robotron10/project_x/README.md

# project_x
Abschlussprojekt automatisches Gewächshaus
