robotron10/project_x/doxygen/latex/pumpe__1_8cpp.tex

\hypertarget{pumpe__1_8cpp}{}\section{/home/zero/abschlussprojekt/pumpe\+\_\+1.cpp-\/\+Dateireferenz}
\label{pumpe__1_8cpp}\index{/home/zero/abschlussprojekt/pumpe\+\_\+1.\+cpp@{/home/zero/abschlussprojekt/pumpe\+\_\+1.\+cpp}}
{\ttfamily \#include $<$Arduino.\+h$>$}\newline
{\ttfamily \#include \char`\"{}makros.\+h\char`\"{}}\newline
{\ttfamily \#include \char`\"{}tuer\+\_\+zu.\+h\char`\"{}}\newline
{\ttfamily \#include \char`\"{}pumpe\+\_\+1.\+h\char`\"{}}\newline
Include-\/\+Abhängigkeitsdiagramm für pumpe\+\_\+1.\+cpp\+:
\nopagebreak
\begin{figure}[H]
\begin{center}
\leavevmode
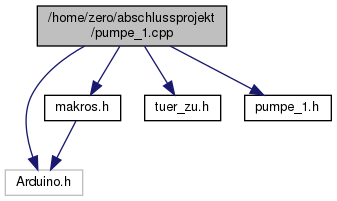
[picture p2: doxygen/html/pumpe__1_8cpp__incl.png]

\end{center}
\end{figure}
\subsection*{Funktionen}
\begin{DoxyCompactItemize}
\item 
void \hyperlink{pumpe__1_8cpp_ab395b141ee439daa2552b2aee993de59}{pumpen\+\_\+1} ()
\begin{DoxyCompactList}\small\item\em Zustandsautomat Pumpe 1 ///. \end{DoxyCompactList}\end{DoxyCompactItemize}
\subsection*{Variablen}
\begin{DoxyCompactItemize}
\item 
int \hyperlink{pumpe__1_8cpp_afa416e7460cf043207be351d750b97fe}{hum\+\_\+erde\+\_\+1\+\_\+adc}
\item 
int \hyperlink{pumpe__1_8cpp_abb1c509cfb119e70585771234accdc4c}{limit\+\_\+feuchte\+\_\+1\+\_\+adc}
\item 
unsigned long \hyperlink{pumpe__1_8cpp_abb7944bc8f9499e8ee84d361d823f122}{t0\+\_\+pumpe\+\_\+1}
\item 
unsigned long \hyperlink{pumpe__1_8cpp_ad2fcb732158343baf6f03db3f44377d0}{dt\+\_\+pumpendauer\+\_\+1\+\_\+ms} = 5000
\item 
unsigned long \hyperlink{pumpe__1_8cpp_a562f2a69077e9416bef8bcb843261334}{t0\+\_\+durchfeuchtung\+\_\+1}
\item 
unsigned long \hyperlink{pumpe__1_8cpp_a8dcdc9f5bd8d9fd59fdf7a54869ebd81}{dt\+\_\+warten\+\_\+durchfeuchtung\+\_\+1\+\_\+ms} = 10000
\item 
int \hyperlink{pumpe__1_8cpp_a312a74000d8f9d74536e66d0a5e7bfc4}{zustand\+\_\+1} = \hyperlink{makros_8h_acd99f73b20037e5fcba7a4a031e0f320}{zustand\+\_\+warten\+\_\+zu\+\_\+trocken}
\end{DoxyCompactItemize}

\subsection{Dokumentation der Funktionen}
\mbox{\Hypertarget{pumpe__1_8cpp_ab395b141ee439daa2552b2aee993de59}\label{pumpe__1_8cpp_ab395b141ee439daa2552b2aee993de59}} 
\index{pumpe\+\_\+1.\+cpp@{pumpe\+\_\+1.\+cpp}!pumpen\+\_\+1@{pumpen\+\_\+1}}
\index{pumpen\+\_\+1@{pumpen\+\_\+1}!pumpe\+\_\+1.\+cpp@{pumpe\+\_\+1.\+cpp}}
\subsubsection{\texorpdfstring{pumpen\+\_\+1()}{pumpen\_1()}}
{\footnotesize\ttfamily void pumpen\+\_\+1 (\begin{DoxyParamCaption}\item[{void}]{ }\end{DoxyParamCaption})}

Zustandsautomat Pumpe 1 ///. 

Definiert in Zeile 16 der Datei pumpe\+\_\+1.\+cpp.

\subsection{Variablen-\/\+Dokumentation}
\mbox{\Hypertarget{pumpe__1_8cpp_ad2fcb732158343baf6f03db3f44377d0}\label{pumpe__1_8cpp_ad2fcb732158343baf6f03db3f44377d0}} 
\index{pumpe\+\_\+1.\+cpp@{pumpe\+\_\+1.\+cpp}!dt\+\_\+pumpendauer\+\_\+1\+\_\+ms@{dt\+\_\+pumpendauer\+\_\+1\+\_\+ms}}
\index{dt\+\_\+pumpendauer\+\_\+1\+\_\+ms@{dt\+\_\+pumpendauer\+\_\+1\+\_\+ms}!pumpe\+\_\+1.\+cpp@{pumpe\+\_\+1.\+cpp}}
\subsubsection{\texorpdfstring{dt\+\_\+pumpendauer\+\_\+1\+\_\+ms}{dt\_pumpendauer\_1\_ms}}
{\footnotesize\ttfamily unsigned long dt\+\_\+pumpendauer\+\_\+1\+\_\+ms = 5000}

Definiert in Zeile 10 der Datei pumpe\+\_\+1.\+cpp.

\mbox{\Hypertarget{pumpe__1_8cpp_a8dcdc9f5bd8d9fd59fdf7a54869ebd81}\label{pumpe__1_8cpp_a8dcdc9f5bd8d9fd59fdf7a54869ebd81}} 
\index{pumpe\+\_\+1.\+cpp@{pumpe\+\_\+1.\+cpp}!dt\+\_\+warten\+\_\+durchfeuchtung\+\_\+1\+\_\+ms@{dt\+\_\+warten\+\_\+durchfeuchtung\+\_\+1\+\_\+ms}}
\index{dt\+\_\+warten\+\_\+durchfeuchtung\+\_\+1\+\_\+ms@{dt\+\_\+warten\+\_\+durchfeuchtung\+\_\+1\+\_\+ms}!pumpe\+\_\+1.\+cpp@{pumpe\+\_\+1.\+cpp}}
\subsubsection{\texorpdfstring{dt\+\_\+warten\+\_\+durchfeuchtung\+\_\+1\+\_\+ms}{dt\_warten\_durchfeuchtung\_1\_ms}}
{\footnotesize\ttfamily unsigned long dt\+\_\+warten\+\_\+durchfeuchtung\+\_\+1\+\_\+ms = 10000}

Definiert in Zeile 12 der Datei pumpe\+\_\+1.\+cpp.

\mbox{\Hypertarget{pumpe__1_8cpp_afa416e7460cf043207be351d750b97fe}\label{pumpe__1_8cpp_afa416e7460cf043207be351d750b97fe}} 
\index{pumpe\+\_\+1.\+cpp@{pumpe\+\_\+1.\+cpp}!hum\+\_\+erde\+\_\+1\+\_\+adc@{hum\+\_\+erde\+\_\+1\+\_\+adc}}
\index{hum\+\_\+erde\+\_\+1\+\_\+adc@{hum\+\_\+erde\+\_\+1\+\_\+adc}!pumpe\+\_\+1.\+cpp@{pumpe\+\_\+1.\+cpp}}
\subsubsection{\texorpdfstring{hum\+\_\+erde\+\_\+1\+\_\+adc}{hum\_erde\_1\_adc}}
{\footnotesize\ttfamily int hum\+\_\+erde\+\_\+1\+\_\+adc}

Definiert in Zeile 46 der Datei abschlussprojekt.\+c.

\mbox{\Hypertarget{pumpe__1_8cpp_abb1c509cfb119e70585771234accdc4c}\label{pumpe__1_8cpp_abb1c509cfb119e70585771234accdc4c}} 
\index{pumpe\+\_\+1.\+cpp@{pumpe\+\_\+1.\+cpp}!limit\+\_\+feuchte\+\_\+1\+\_\+adc@{limit\+\_\+feuchte\+\_\+1\+\_\+adc}}
\index{limit\+\_\+feuchte\+\_\+1\+\_\+adc@{limit\+\_\+feuchte\+\_\+1\+\_\+adc}!pumpe\+\_\+1.\+cpp@{pumpe\+\_\+1.\+cpp}}
\subsubsection{\texorpdfstring{limit\+\_\+feuchte\+\_\+1\+\_\+adc}{limit\_feuchte\_1\_adc}}
{\footnotesize\ttfamily int limit\+\_\+feuchte\+\_\+1\+\_\+adc}

Definiert in Zeile 52 der Datei abschlussprojekt.\+c.

\mbox{\Hypertarget{pumpe__1_8cpp_a562f2a69077e9416bef8bcb843261334}\label{pumpe__1_8cpp_a562f2a69077e9416bef8bcb843261334}} 
\index{pumpe\+\_\+1.\+cpp@{pumpe\+\_\+1.\+cpp}!t0\+\_\+durchfeuchtung\+\_\+1@{t0\+\_\+durchfeuchtung\+\_\+1}}
\index{t0\+\_\+durchfeuchtung\+\_\+1@{t0\+\_\+durchfeuchtung\+\_\+1}!pumpe\+\_\+1.\+cpp@{pumpe\+\_\+1.\+cpp}}
\subsubsection{\texorpdfstring{t0\+\_\+durchfeuchtung\+\_\+1}{t0\_durchfeuchtung\_1}}
{\footnotesize\ttfamily unsigned long t0\+\_\+durchfeuchtung\+\_\+1}

Definiert in Zeile 11 der Datei pumpe\+\_\+1.\+cpp.

\mbox{\Hypertarget{pumpe__1_8cpp_abb7944bc8f9499e8ee84d361d823f122}\label{pumpe__1_8cpp_abb7944bc8f9499e8ee84d361d823f122}} 
\index{pumpe\+\_\+1.\+cpp@{pumpe\+\_\+1.\+cpp}!t0\+\_\+pumpe\+\_\+1@{t0\+\_\+pumpe\+\_\+1}}
\index{t0\+\_\+pumpe\+\_\+1@{t0\+\_\+pumpe\+\_\+1}!pumpe\+\_\+1.\+cpp@{pumpe\+\_\+1.\+cpp}}
\subsubsection{\texorpdfstring{t0\+\_\+pumpe\+\_\+1}{t0\_pumpe\_1}}
{\footnotesize\ttfamily unsigned long t0\+\_\+pumpe\+\_\+1}

Definiert in Zeile 9 der Datei pumpe\+\_\+1.\+cpp.

\mbox{\Hypertarget{pumpe__1_8cpp_a312a74000d8f9d74536e66d0a5e7bfc4}\label{pumpe__1_8cpp_a312a74000d8f9d74536e66d0a5e7bfc4}} 
\index{pumpe\+\_\+1.\+cpp@{pumpe\+\_\+1.\+cpp}!zustand\+\_\+1@{zustand\+\_\+1}}
\index{zustand\+\_\+1@{zustand\+\_\+1}!pumpe\+\_\+1.\+cpp@{pumpe\+\_\+1.\+cpp}}
\subsubsection{\texorpdfstring{zustand\+\_\+1}{zustand\_1}}
{\footnotesize\ttfamily int zustand\+\_\+1 = \hyperlink{makros_8h_acd99f73b20037e5fcba7a4a031e0f320}{zustand\+\_\+warten\+\_\+zu\+\_\+trocken}}

Definiert in Zeile 14 der Datei pumpe\+\_\+1.\+cpp.
