robotron10/project_x/doxygen/latex/pumpe__1_8h.tex

\hypertarget{pumpe__1_8h}{}\section{/home/zero/abschlussprojekt/pumpe\+\_\+1.h-\/\+Dateireferenz}
\label{pumpe__1_8h}\index{/home/zero/abschlussprojekt/pumpe\+\_\+1.\+h@{/home/zero/abschlussprojekt/pumpe\+\_\+1.\+h}}
Dieser Graph zeigt, welche Datei direkt oder indirekt diese Datei enthält\+:
\nopagebreak
\begin{figure}[H]
\begin{center}
\leavevmode
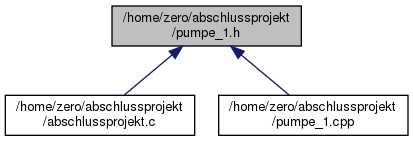
[picture p3: doxygen/html/pumpe__1_8h__dep__incl.png]

\end{center}
\end{figure}
\subsection*{Funktionen}
\begin{DoxyCompactItemize}
\item 
void \hyperlink{pumpe__1_8h_ad672a4455a5f5c803b5fd5ad87a41aa0}{pumpen\+\_\+1} (void)
\begin{DoxyCompactList}\small\item\em Zustandsautomat Pumpe 1 ///. \end{DoxyCompactList}\end{DoxyCompactItemize}

\subsection{Dokumentation der Funktionen}
\mbox{\Hypertarget{pumpe__1_8h_ad672a4455a5f5c803b5fd5ad87a41aa0}\label{pumpe__1_8h_ad672a4455a5f5c803b5fd5ad87a41aa0}} 
\index{pumpe\+\_\+1.\+h@{pumpe\+\_\+1.\+h}!pumpen\+\_\+1@{pumpen\+\_\+1}}
\index{pumpen\+\_\+1@{pumpen\+\_\+1}!pumpe\+\_\+1.\+h@{pumpe\+\_\+1.\+h}}
\subsubsection{\texorpdfstring{pumpen\+\_\+1()}{pumpen\_1()}}
{\footnotesize\ttfamily void pumpen\+\_\+1 (\begin{DoxyParamCaption}\item[{void}]{ }\end{DoxyParamCaption})}

Zustandsautomat Pumpe 1 ///. 

Definiert in Zeile 16 der Datei pumpe\+\_\+1.\+cpp.
