robotron10/project_x/doxygen/latex/pumpe__2_8cpp.tex

\hypertarget{pumpe__2_8cpp}{}\section{/home/zero/abschlussprojekt/pumpe\+\_\+2.cpp-\/\+Dateireferenz}
\label{pumpe__2_8cpp}\index{/home/zero/abschlussprojekt/pumpe\+\_\+2.\+cpp@{/home/zero/abschlussprojekt/pumpe\+\_\+2.\+cpp}}
{\ttfamily \#include $<$Arduino.\+h$>$}\newline
{\ttfamily \#include \char`\"{}makros.\+h\char`\"{}}\newline
{\ttfamily \#include \char`\"{}tuer\+\_\+zu.\+h\char`\"{}}\newline
{\ttfamily \#include \char`\"{}pumpe\+\_\+2.\+h\char`\"{}}\newline
Include-\/\+Abhängigkeitsdiagramm für pumpe\+\_\+2.\+cpp\+:
\nopagebreak
\begin{figure}[H]
\begin{center}
\leavevmode
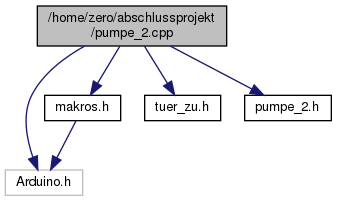
[picture p4: doxygen/html/pumpe__2_8cpp__incl.png]

\end{center}
\end{figure}
\subsection*{Funktionen}
\begin{DoxyCompactItemize}
\item 
void \hyperlink{pumpe__2_8cpp_ab5052e43d029ec1d5b2899be0135e45c}{pumpen\+\_\+2} ()
\begin{DoxyCompactList}\small\item\em Zustandsautomat Pumpe 2 ///. \end{DoxyCompactList}\end{DoxyCompactItemize}
\subsection*{Variablen}
\begin{DoxyCompactItemize}
\item 
int \hyperlink{pumpe__2_8cpp_aacdbec939adcfa404b8c42b2e064b110}{hum\+\_\+erde\+\_\+2\+\_\+adc}
\item 
int \hyperlink{pumpe__2_8cpp_a11941af86181c1d0476b4bad92345dee}{limit\+\_\+feuchte\+\_\+2\+\_\+adc}
\item 
unsigned long \hyperlink{pumpe__2_8cpp_a6ba123b4db543f23167f7579070cb078}{t0\+\_\+pumpe\+\_\+2}
\item 
unsigned long \hyperlink{pumpe__2_8cpp_aa162b2945b33207aaa0e405a04e21049}{dt\+\_\+pumpendauer\+\_\+2\+\_\+ms} = 5000
\item 
unsigned long \hyperlink{pumpe__2_8cpp_ae43a32686ec363ab79244493e815eb1a}{t0\+\_\+durchfeuchtung\+\_\+2}
\item 
unsigned long \hyperlink{pumpe__2_8cpp_ad4082581e55599e78402c968aa6fd220}{dt\+\_\+warten\+\_\+durchfeuchtung\+\_\+2\+\_\+ms} = 10000
\item 
int \hyperlink{pumpe__2_8cpp_ae5d230a4da9cb370063e945d94d7043a}{zustand\+\_\+2} = \hyperlink{makros_8h_acd99f73b20037e5fcba7a4a031e0f320}{zustand\+\_\+warten\+\_\+zu\+\_\+trocken}
\end{DoxyCompactItemize}

\subsection{Dokumentation der Funktionen}
\mbox{\Hypertarget{pumpe__2_8cpp_ab5052e43d029ec1d5b2899be0135e45c}\label{pumpe__2_8cpp_ab5052e43d029ec1d5b2899be0135e45c}} 
\index{pumpe\+\_\+2.\+cpp@{pumpe\+\_\+2.\+cpp}!pumpen\+\_\+2@{pumpen\+\_\+2}}
\index{pumpen\+\_\+2@{pumpen\+\_\+2}!pumpe\+\_\+2.\+cpp@{pumpe\+\_\+2.\+cpp}}
\subsubsection{\texorpdfstring{pumpen\+\_\+2()}{pumpen\_2()}}
{\footnotesize\ttfamily void pumpen\+\_\+2 (\begin{DoxyParamCaption}\item[{void}]{ }\end{DoxyParamCaption})}

Zustandsautomat Pumpe 2 ///. 

Definiert in Zeile 16 der Datei pumpe\+\_\+2.\+cpp.

\subsection{Variablen-\/\+Dokumentation}
\mbox{\Hypertarget{pumpe__2_8cpp_aa162b2945b33207aaa0e405a04e21049}\label{pumpe__2_8cpp_aa162b2945b33207aaa0e405a04e21049}} 
\index{pumpe\+\_\+2.\+cpp@{pumpe\+\_\+2.\+cpp}!dt\+\_\+pumpendauer\+\_\+2\+\_\+ms@{dt\+\_\+pumpendauer\+\_\+2\+\_\+ms}}
\index{dt\+\_\+pumpendauer\+\_\+2\+\_\+ms@{dt\+\_\+pumpendauer\+\_\+2\+\_\+ms}!pumpe\+\_\+2.\+cpp@{pumpe\+\_\+2.\+cpp}}
\subsubsection{\texorpdfstring{dt\+\_\+pumpendauer\+\_\+2\+\_\+ms}{dt\_pumpendauer\_2\_ms}}
{\footnotesize\ttfamily unsigned long dt\+\_\+pumpendauer\+\_\+2\+\_\+ms = 5000}

Definiert in Zeile 10 der Datei pumpe\+\_\+2.\+cpp.

\mbox{\Hypertarget{pumpe__2_8cpp_ad4082581e55599e78402c968aa6fd220}\label{pumpe__2_8cpp_ad4082581e55599e78402c968aa6fd220}} 
\index{pumpe\+\_\+2.\+cpp@{pumpe\+\_\+2.\+cpp}!dt\+\_\+warten\+\_\+durchfeuchtung\+\_\+2\+\_\+ms@{dt\+\_\+warten\+\_\+durchfeuchtung\+\_\+2\+\_\+ms}}
\index{dt\+\_\+warten\+\_\+durchfeuchtung\+\_\+2\+\_\+ms@{dt\+\_\+warten\+\_\+durchfeuchtung\+\_\+2\+\_\+ms}!pumpe\+\_\+2.\+cpp@{pumpe\+\_\+2.\+cpp}}
\subsubsection{\texorpdfstring{dt\+\_\+warten\+\_\+durchfeuchtung\+\_\+2\+\_\+ms}{dt\_warten\_durchfeuchtung\_2\_ms}}
{\footnotesize\ttfamily unsigned long dt\+\_\+warten\+\_\+durchfeuchtung\+\_\+2\+\_\+ms = 10000}

Definiert in Zeile 12 der Datei pumpe\+\_\+2.\+cpp.

\mbox{\Hypertarget{pumpe__2_8cpp_aacdbec939adcfa404b8c42b2e064b110}\label{pumpe__2_8cpp_aacdbec939adcfa404b8c42b2e064b110}} 
\index{pumpe\+\_\+2.\+cpp@{pumpe\+\_\+2.\+cpp}!hum\+\_\+erde\+\_\+2\+\_\+adc@{hum\+\_\+erde\+\_\+2\+\_\+adc}}
\index{hum\+\_\+erde\+\_\+2\+\_\+adc@{hum\+\_\+erde\+\_\+2\+\_\+adc}!pumpe\+\_\+2.\+cpp@{pumpe\+\_\+2.\+cpp}}
\subsubsection{\texorpdfstring{hum\+\_\+erde\+\_\+2\+\_\+adc}{hum\_erde\_2\_adc}}
{\footnotesize\ttfamily int hum\+\_\+erde\+\_\+2\+\_\+adc}

Definiert in Zeile 47 der Datei abschlussprojekt.\+c.

\mbox{\Hypertarget{pumpe__2_8cpp_a11941af86181c1d0476b4bad92345dee}\label{pumpe__2_8cpp_a11941af86181c1d0476b4bad92345dee}} 
\index{pumpe\+\_\+2.\+cpp@{pumpe\+\_\+2.\+cpp}!limit\+\_\+feuchte\+\_\+2\+\_\+adc@{limit\+\_\+feuchte\+\_\+2\+\_\+adc}}
\index{limit\+\_\+feuchte\+\_\+2\+\_\+adc@{limit\+\_\+feuchte\+\_\+2\+\_\+adc}!pumpe\+\_\+2.\+cpp@{pumpe\+\_\+2.\+cpp}}
\subsubsection{\texorpdfstring{limit\+\_\+feuchte\+\_\+2\+\_\+adc}{limit\_feuchte\_2\_adc}}
{\footnotesize\ttfamily int limit\+\_\+feuchte\+\_\+2\+\_\+adc}

Definiert in Zeile 53 der Datei abschlussprojekt.\+c.

\mbox{\Hypertarget{pumpe__2_8cpp_ae43a32686ec363ab79244493e815eb1a}\label{pumpe__2_8cpp_ae43a32686ec363ab79244493e815eb1a}} 
\index{pumpe\+\_\+2.\+cpp@{pumpe\+\_\+2.\+cpp}!t0\+\_\+durchfeuchtung\+\_\+2@{t0\+\_\+durchfeuchtung\+\_\+2}}
\index{t0\+\_\+durchfeuchtung\+\_\+2@{t0\+\_\+durchfeuchtung\+\_\+2}!pumpe\+\_\+2.\+cpp@{pumpe\+\_\+2.\+cpp}}
\subsubsection{\texorpdfstring{t0\+\_\+durchfeuchtung\+\_\+2}{t0\_durchfeuchtung\_2}}
{\footnotesize\ttfamily unsigned long t0\+\_\+durchfeuchtung\+\_\+2}

Definiert in Zeile 11 der Datei pumpe\+\_\+2.\+cpp.

\mbox{\Hypertarget{pumpe__2_8cpp_a6ba123b4db543f23167f7579070cb078}\label{pumpe__2_8cpp_a6ba123b4db543f23167f7579070cb078}} 
\index{pumpe\+\_\+2.\+cpp@{pumpe\+\_\+2.\+cpp}!t0\+\_\+pumpe\+\_\+2@{t0\+\_\+pumpe\+\_\+2}}
\index{t0\+\_\+pumpe\+\_\+2@{t0\+\_\+pumpe\+\_\+2}!pumpe\+\_\+2.\+cpp@{pumpe\+\_\+2.\+cpp}}
\subsubsection{\texorpdfstring{t0\+\_\+pumpe\+\_\+2}{t0\_pumpe\_2}}
{\footnotesize\ttfamily unsigned long t0\+\_\+pumpe\+\_\+2}

Definiert in Zeile 9 der Datei pumpe\+\_\+2.\+cpp.

\mbox{\Hypertarget{pumpe__2_8cpp_ae5d230a4da9cb370063e945d94d7043a}\label{pumpe__2_8cpp_ae5d230a4da9cb370063e945d94d7043a}} 
\index{pumpe\+\_\+2.\+cpp@{pumpe\+\_\+2.\+cpp}!zustand\+\_\+2@{zustand\+\_\+2}}
\index{zustand\+\_\+2@{zustand\+\_\+2}!pumpe\+\_\+2.\+cpp@{pumpe\+\_\+2.\+cpp}}
\subsubsection{\texorpdfstring{zustand\+\_\+2}{zustand\_2}}
{\footnotesize\ttfamily int zustand\+\_\+2 = \hyperlink{makros_8h_acd99f73b20037e5fcba7a4a031e0f320}{zustand\+\_\+warten\+\_\+zu\+\_\+trocken}}

Definiert in Zeile 14 der Datei pumpe\+\_\+2.\+cpp.
