robotron10/project_x/doxygen/latex/pumpe__2_8h.tex

\hypertarget{pumpe__2_8h}{}\section{/home/zero/abschlussprojekt/pumpe\+\_\+2.h-\/\+Dateireferenz}
\label{pumpe__2_8h}\index{/home/zero/abschlussprojekt/pumpe\+\_\+2.\+h@{/home/zero/abschlussprojekt/pumpe\+\_\+2.\+h}}
Dieser Graph zeigt, welche Datei direkt oder indirekt diese Datei enthält\+:
\nopagebreak
\begin{figure}[H]
\begin{center}
\leavevmode
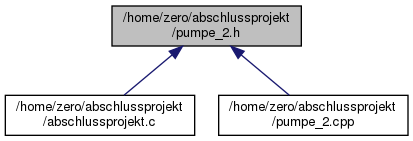
[picture p5: doxygen/html/pumpe__2_8h__dep__incl.png]

\end{center}
\end{figure}
\subsection*{Funktionen}
\begin{DoxyCompactItemize}
\item 
void \hyperlink{pumpe__2_8h_a754bd6f3d38e83cc0365704a45bf8f37}{pumpen\+\_\+2} (void)
\begin{DoxyCompactList}\small\item\em Zustandsautomat Pumpe 2 ///. \end{DoxyCompactList}\end{DoxyCompactItemize}

\subsection{Dokumentation der Funktionen}
\mbox{\Hypertarget{pumpe__2_8h_a754bd6f3d38e83cc0365704a45bf8f37}\label{pumpe__2_8h_a754bd6f3d38e83cc0365704a45bf8f37}} 
\index{pumpe\+\_\+2.\+h@{pumpe\+\_\+2.\+h}!pumpen\+\_\+2@{pumpen\+\_\+2}}
\index{pumpen\+\_\+2@{pumpen\+\_\+2}!pumpe\+\_\+2.\+h@{pumpe\+\_\+2.\+h}}
\subsubsection{\texorpdfstring{pumpen\+\_\+2()}{pumpen\_2()}}
{\footnotesize\ttfamily void pumpen\+\_\+2 (\begin{DoxyParamCaption}\item[{void}]{ }\end{DoxyParamCaption})}

Zustandsautomat Pumpe 2 ///. 

Definiert in Zeile 16 der Datei pumpe\+\_\+2.\+cpp.
