robotron10/project_x/doxygen/latex/update__lcd_8h.tex

\hypertarget{update__lcd_8h}{}\section{/home/zero/abschlussprojekt/update\+\_\+lcd.h-\/\+Dateireferenz}
\label{update__lcd_8h}\index{/home/zero/abschlussprojekt/update\+\_\+lcd.\+h@{/home/zero/abschlussprojekt/update\+\_\+lcd.\+h}}
{\ttfamily \#include $<$Arduino.\+h$>$}\newline
{\ttfamily \#include $<$Liquid\+Crystal\+\_\+\+I2\+C.\+h$>$}\newline
{\ttfamily \#include \char`\"{}make\+\_\+string.\+h\char`\"{}}\newline
Include-\/\+Abhängigkeitsdiagramm für update\+\_\+lcd.\+h\+:
\nopagebreak
\begin{figure}[H]
\begin{center}
\leavevmode
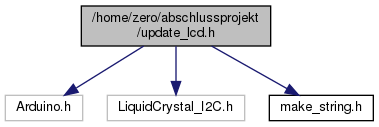
[picture p6: doxygen/html/update__lcd_8h__incl.png]

\end{center}
\end{figure}
Dieser Graph zeigt, welche Datei direkt oder indirekt diese Datei enthält\+:
\nopagebreak
\begin{figure}[H]
\begin{center}
\leavevmode
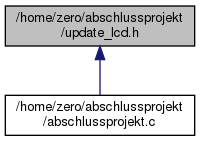
[picture p7: doxygen/html/update__lcd_8h__dep__incl.png]

\end{center}
\end{figure}
\subsection*{Funktionen}
\begin{DoxyCompactItemize}
\item 
Liquid\+Crystal\+\_\+\+I2C \hyperlink{update__lcd_8h_a7392e8043ba37d68cf0d13e0264acd85}{lcd} (0x3\+F, 20, 4)
\item 
void \hyperlink{update__lcd_8h_a23904742a80994988f92b99487c299ca}{update\+\_\+lcd} (int nr\+\_\+display, int \hyperlink{update__messwerte_8h_a0e6f058da75dead800f4a33e63586703}{temp\+\_\+luft\+\_\+C}, int \hyperlink{update__messwerte_8h_ac9fcb87eca48e4002731015e004966ef}{hum\+\_\+luft}, int \hyperlink{update__messwerte_8h_afa416e7460cf043207be351d750b97fe}{hum\+\_\+erde\+\_\+1\+\_\+adc}, int \hyperlink{update__messwerte_8h_aacdbec939adcfa404b8c42b2e064b110}{hum\+\_\+erde\+\_\+2\+\_\+adc}, int \hyperlink{update__limits_8cpp_abb1c509cfb119e70585771234accdc4c}{limit\+\_\+feuchte\+\_\+1\+\_\+adc}, int \hyperlink{update__limits_8cpp_a11941af86181c1d0476b4bad92345dee}{limit\+\_\+feuchte\+\_\+2\+\_\+adc}, int \hyperlink{update__limits_8cpp_a8f0ffb4ec25253a324ab4dac6d3cf1c4}{limit\+\_\+temp\+\_\+adc}, int \hyperlink{update__limits_8cpp_a3f6dd9ed3b997c063d7c90a38a69ab3a}{limit\+\_\+luefter\+\_\+adc})
\end{DoxyCompactItemize}

\subsection{Dokumentation der Funktionen}
\mbox{\Hypertarget{update__lcd_8h_a7392e8043ba37d68cf0d13e0264acd85}\label{update__lcd_8h_a7392e8043ba37d68cf0d13e0264acd85}} 
\index{update\+\_\+lcd.\+h@{update\+\_\+lcd.\+h}!lcd@{lcd}}
\index{lcd@{lcd}!update\+\_\+lcd.\+h@{update\+\_\+lcd.\+h}}
\subsubsection{\texorpdfstring{lcd()}{lcd()}}
{\footnotesize\ttfamily Liquid\+Crystal\+\_\+\+I2C lcd (\begin{DoxyParamCaption}\item[{0x3F}]{,  }\item[{20}]{,  }\item[{4}]{ }\end{DoxyParamCaption})}

\mbox{\Hypertarget{update__lcd_8h_a23904742a80994988f92b99487c299ca}\label{update__lcd_8h_a23904742a80994988f92b99487c299ca}} 
\index{update\+\_\+lcd.\+h@{update\+\_\+lcd.\+h}!update\+\_\+lcd@{update\+\_\+lcd}}
\index{update\+\_\+lcd@{update\+\_\+lcd}!update\+\_\+lcd.\+h@{update\+\_\+lcd.\+h}}
\subsubsection{\texorpdfstring{update\+\_\+lcd()}{update\_lcd()}}
{\footnotesize\ttfamily void update\+\_\+lcd (\begin{DoxyParamCaption}\item[{int}]{nr\+\_\+display,  }\item[{int}]{temp\+\_\+luft\+\_\+C,  }\item[{int}]{hum\+\_\+luft,  }\item[{int}]{hum\+\_\+erde\+\_\+1\+\_\+adc,  }\item[{int}]{hum\+\_\+erde\+\_\+2\+\_\+adc,  }\item[{int}]{limit\+\_\+feuchte\+\_\+1\+\_\+adc,  }\item[{int}]{limit\+\_\+feuchte\+\_\+2\+\_\+adc,  }\item[{int}]{limit\+\_\+temp\+\_\+adc,  }\item[{int}]{limit\+\_\+luefter\+\_\+adc }\end{DoxyParamCaption})}

Definiert in Zeile 8 der Datei update\+\_\+lcd.\+h.
