robotron10/project_x/doxygen/latex/update__limits_8cpp.tex

\hypertarget{update__limits_8cpp}{}\section{/home/zero/abschlussprojekt/update\+\_\+limits.cpp-\/\+Dateireferenz}
\label{update__limits_8cpp}\index{/home/zero/abschlussprojekt/update\+\_\+limits.\+cpp@{/home/zero/abschlussprojekt/update\+\_\+limits.\+cpp}}
{\ttfamily \#include $<$Arduino.\+h$>$}\newline
{\ttfamily \#include \char`\"{}makros.\+h\char`\"{}}\newline
{\ttfamily \#include \char`\"{}update\+\_\+limits.\+h\char`\"{}}\newline
Include-\/\+Abhängigkeitsdiagramm für update\+\_\+limits.\+cpp\+:
\nopagebreak
\begin{figure}[H]
\begin{center}
\leavevmode
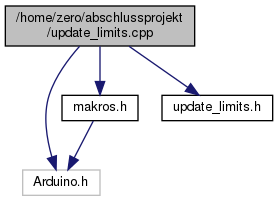
[picture p8: doxygen/html/update__limits_8cpp__incl.png]

\end{center}
\end{figure}
\subsection*{Funktionen}
\begin{DoxyCompactItemize}
\item 
void \hyperlink{update__limits_8cpp_a1efb14d12b812e3a0f08188dbaeccc5e}{update\+\_\+limits} ()
\begin{DoxyCompactList}\small\item\em aktualisieren der Schwellenwerte /// \end{DoxyCompactList}\end{DoxyCompactItemize}
\subsection*{Variablen}
\begin{DoxyCompactItemize}
\item 
int \hyperlink{update__limits_8cpp_abb1c509cfb119e70585771234accdc4c}{limit\+\_\+feuchte\+\_\+1\+\_\+adc}
\item 
int \hyperlink{update__limits_8cpp_a11941af86181c1d0476b4bad92345dee}{limit\+\_\+feuchte\+\_\+2\+\_\+adc}
\item 
int \hyperlink{update__limits_8cpp_a8f0ffb4ec25253a324ab4dac6d3cf1c4}{limit\+\_\+temp\+\_\+adc}
\item 
int \hyperlink{update__limits_8cpp_a7af3ab4da71f5b8ce8c0d93640690817}{limit\+\_\+temp\+\_\+C}
\item 
int \hyperlink{update__limits_8cpp_a3f6dd9ed3b997c063d7c90a38a69ab3a}{limit\+\_\+luefter\+\_\+adc}
\item 
int \hyperlink{update__limits_8cpp_a27d916670e311d9e7881ebdc4807e0f5}{limit\+\_\+luefter\+\_\+C}
\end{DoxyCompactItemize}

\subsection{Dokumentation der Funktionen}
\mbox{\Hypertarget{update__limits_8cpp_a1efb14d12b812e3a0f08188dbaeccc5e}\label{update__limits_8cpp_a1efb14d12b812e3a0f08188dbaeccc5e}} 
\index{update\+\_\+limits.\+cpp@{update\+\_\+limits.\+cpp}!update\+\_\+limits@{update\+\_\+limits}}
\index{update\+\_\+limits@{update\+\_\+limits}!update\+\_\+limits.\+cpp@{update\+\_\+limits.\+cpp}}
\subsubsection{\texorpdfstring{update\+\_\+limits()}{update\_limits()}}
{\footnotesize\ttfamily void update\+\_\+limits (\begin{DoxyParamCaption}\item[{void}]{ }\end{DoxyParamCaption})}

aktualisieren der Schwellenwerte /// 

Definiert in Zeile 13 der Datei update\+\_\+limits.\+cpp.

\subsection{Variablen-\/\+Dokumentation}
\mbox{\Hypertarget{update__limits_8cpp_abb1c509cfb119e70585771234accdc4c}\label{update__limits_8cpp_abb1c509cfb119e70585771234accdc4c}} 
\index{update\+\_\+limits.\+cpp@{update\+\_\+limits.\+cpp}!limit\+\_\+feuchte\+\_\+1\+\_\+adc@{limit\+\_\+feuchte\+\_\+1\+\_\+adc}}
\index{limit\+\_\+feuchte\+\_\+1\+\_\+adc@{limit\+\_\+feuchte\+\_\+1\+\_\+adc}!update\+\_\+limits.\+cpp@{update\+\_\+limits.\+cpp}}
\subsubsection{\texorpdfstring{limit\+\_\+feuchte\+\_\+1\+\_\+adc}{limit\_feuchte\_1\_adc}}
{\footnotesize\ttfamily int limit\+\_\+feuchte\+\_\+1\+\_\+adc}

Definiert in Zeile 52 der Datei abschlussprojekt.\+c.

\mbox{\Hypertarget{update__limits_8cpp_a11941af86181c1d0476b4bad92345dee}\label{update__limits_8cpp_a11941af86181c1d0476b4bad92345dee}} 
\index{update\+\_\+limits.\+cpp@{update\+\_\+limits.\+cpp}!limit\+\_\+feuchte\+\_\+2\+\_\+adc@{limit\+\_\+feuchte\+\_\+2\+\_\+adc}}
\index{limit\+\_\+feuchte\+\_\+2\+\_\+adc@{limit\+\_\+feuchte\+\_\+2\+\_\+adc}!update\+\_\+limits.\+cpp@{update\+\_\+limits.\+cpp}}
\subsubsection{\texorpdfstring{limit\+\_\+feuchte\+\_\+2\+\_\+adc}{limit\_feuchte\_2\_adc}}
{\footnotesize\ttfamily int limit\+\_\+feuchte\+\_\+2\+\_\+adc}

Definiert in Zeile 53 der Datei abschlussprojekt.\+c.

\mbox{\Hypertarget{update__limits_8cpp_a3f6dd9ed3b997c063d7c90a38a69ab3a}\label{update__limits_8cpp_a3f6dd9ed3b997c063d7c90a38a69ab3a}} 
\index{update\+\_\+limits.\+cpp@{update\+\_\+limits.\+cpp}!limit\+\_\+luefter\+\_\+adc@{limit\+\_\+luefter\+\_\+adc}}
\index{limit\+\_\+luefter\+\_\+adc@{limit\+\_\+luefter\+\_\+adc}!update\+\_\+limits.\+cpp@{update\+\_\+limits.\+cpp}}
\subsubsection{\texorpdfstring{limit\+\_\+luefter\+\_\+adc}{limit\_luefter\_adc}}
{\footnotesize\ttfamily int limit\+\_\+luefter\+\_\+adc}

Definiert in Zeile 56 der Datei abschlussprojekt.\+c.

\mbox{\Hypertarget{update__limits_8cpp_a27d916670e311d9e7881ebdc4807e0f5}\label{update__limits_8cpp_a27d916670e311d9e7881ebdc4807e0f5}} 
\index{update\+\_\+limits.\+cpp@{update\+\_\+limits.\+cpp}!limit\+\_\+luefter\+\_\+C@{limit\+\_\+luefter\+\_\+C}}
\index{limit\+\_\+luefter\+\_\+C@{limit\+\_\+luefter\+\_\+C}!update\+\_\+limits.\+cpp@{update\+\_\+limits.\+cpp}}
\subsubsection{\texorpdfstring{limit\+\_\+luefter\+\_\+C}{limit\_luefter\_C}}
{\footnotesize\ttfamily int limit\+\_\+luefter\+\_\+C}

Definiert in Zeile 57 der Datei abschlussprojekt.\+c.

\mbox{\Hypertarget{update__limits_8cpp_a8f0ffb4ec25253a324ab4dac6d3cf1c4}\label{update__limits_8cpp_a8f0ffb4ec25253a324ab4dac6d3cf1c4}} 
\index{update\+\_\+limits.\+cpp@{update\+\_\+limits.\+cpp}!limit\+\_\+temp\+\_\+adc@{limit\+\_\+temp\+\_\+adc}}
\index{limit\+\_\+temp\+\_\+adc@{limit\+\_\+temp\+\_\+adc}!update\+\_\+limits.\+cpp@{update\+\_\+limits.\+cpp}}
\subsubsection{\texorpdfstring{limit\+\_\+temp\+\_\+adc}{limit\_temp\_adc}}
{\footnotesize\ttfamily int limit\+\_\+temp\+\_\+adc}

Definiert in Zeile 54 der Datei abschlussprojekt.\+c.

\mbox{\Hypertarget{update__limits_8cpp_a7af3ab4da71f5b8ce8c0d93640690817}\label{update__limits_8cpp_a7af3ab4da71f5b8ce8c0d93640690817}} 
\index{update\+\_\+limits.\+cpp@{update\+\_\+limits.\+cpp}!limit\+\_\+temp\+\_\+C@{limit\+\_\+temp\+\_\+C}}
\index{limit\+\_\+temp\+\_\+C@{limit\+\_\+temp\+\_\+C}!update\+\_\+limits.\+cpp@{update\+\_\+limits.\+cpp}}
\subsubsection{\texorpdfstring{limit\+\_\+temp\+\_\+C}{limit\_temp\_C}}
{\footnotesize\ttfamily int limit\+\_\+temp\+\_\+C}

Definiert in Zeile 55 der Datei abschlussprojekt.\+c.
