robotron10/project_x/doxygen/latex/update__messwerte_8h.tex

\hypertarget{update__messwerte_8h}{}\section{/home/zero/abschlussprojekt/update\+\_\+messwerte.h-\/\+Dateireferenz}
\label{update__messwerte_8h}\index{/home/zero/abschlussprojekt/update\+\_\+messwerte.\+h@{/home/zero/abschlussprojekt/update\+\_\+messwerte.\+h}}
{\ttfamily \#include $<$Arduino.\+h$>$}\newline
{\ttfamily \#include \char`\"{}makros.\+h\char`\"{}}\newline
{\ttfamily \#include \char`\"{}D\+H\+T.\+h\char`\"{}}\newline
Include-\/\+Abhängigkeitsdiagramm für update\+\_\+messwerte.\+h\+:
\nopagebreak
\begin{figure}[H]
\begin{center}
\leavevmode
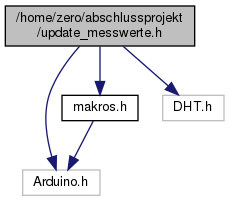
[picture p9: doxygen/html/update__messwerte_8h__incl.png]

\end{center}
\end{figure}
Dieser Graph zeigt, welche Datei direkt oder indirekt diese Datei enthält\+:
\nopagebreak
\begin{figure}[H]
\begin{center}
\leavevmode
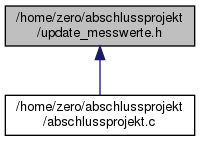
[picture p10: doxygen/html/update__messwerte_8h__dep__incl.png]

\end{center}
\end{figure}
\subsection*{Funktionen}
\begin{DoxyCompactItemize}
\item 
D\+HT \hyperlink{update__messwerte_8h_a94f388d273b0cbe6d7f3c0d5817f688b}{dht} (\hyperlink{makros_8h_a9894c05769fdf48b3506408030591a65}{T\+E\+M\+P\+E\+R\+A\+T\+U\+R\+S\+E\+N\+S\+O\+R\+\_\+\+L\+U\+E\+F\+T\+ER}, \hyperlink{makros_8h_a2c509dba12bba99883a5be9341b7a0c5}{D\+H\+T\+T\+Y\+PE})
\item 
void \hyperlink{update__messwerte_8h_a992b1037e3565070916e60498c1a62ff}{update\+\_\+messwerte} ()
\end{DoxyCompactItemize}
\subsection*{Variablen}
\begin{DoxyCompactItemize}
\item 
int \hyperlink{update__messwerte_8h_afa416e7460cf043207be351d750b97fe}{hum\+\_\+erde\+\_\+1\+\_\+adc}
\item 
int \hyperlink{update__messwerte_8h_aacdbec939adcfa404b8c42b2e064b110}{hum\+\_\+erde\+\_\+2\+\_\+adc}
\item 
int \hyperlink{update__messwerte_8h_ac9fcb87eca48e4002731015e004966ef}{hum\+\_\+luft}
\item 
int \hyperlink{update__messwerte_8h_a0e6f058da75dead800f4a33e63586703}{temp\+\_\+luft\+\_\+C}
\end{DoxyCompactItemize}

\subsection{Dokumentation der Funktionen}
\mbox{\Hypertarget{update__messwerte_8h_a94f388d273b0cbe6d7f3c0d5817f688b}\label{update__messwerte_8h_a94f388d273b0cbe6d7f3c0d5817f688b}} 
\index{update\+\_\+messwerte.\+h@{update\+\_\+messwerte.\+h}!dht@{dht}}
\index{dht@{dht}!update\+\_\+messwerte.\+h@{update\+\_\+messwerte.\+h}}
\subsubsection{\texorpdfstring{dht()}{dht()}}
{\footnotesize\ttfamily D\+HT dht (\begin{DoxyParamCaption}\item[{\hyperlink{makros_8h_a9894c05769fdf48b3506408030591a65}{T\+E\+M\+P\+E\+R\+A\+T\+U\+R\+S\+E\+N\+S\+O\+R\+\_\+\+L\+U\+E\+F\+T\+ER}}]{,  }\item[{\hyperlink{makros_8h_a2c509dba12bba99883a5be9341b7a0c5}{D\+H\+T\+T\+Y\+PE}}]{ }\end{DoxyParamCaption})}

\mbox{\Hypertarget{update__messwerte_8h_a992b1037e3565070916e60498c1a62ff}\label{update__messwerte_8h_a992b1037e3565070916e60498c1a62ff}} 
\index{update\+\_\+messwerte.\+h@{update\+\_\+messwerte.\+h}!update\+\_\+messwerte@{update\+\_\+messwerte}}
\index{update\+\_\+messwerte@{update\+\_\+messwerte}!update\+\_\+messwerte.\+h@{update\+\_\+messwerte.\+h}}
\subsubsection{\texorpdfstring{update\+\_\+messwerte()}{update\_messwerte()}}
{\footnotesize\ttfamily void update\+\_\+messwerte (\begin{DoxyParamCaption}{ }\end{DoxyParamCaption})}

Definiert in Zeile 14 der Datei update\+\_\+messwerte.\+h.

\subsection{Variablen-\/\+Dokumentation}
\mbox{\Hypertarget{update__messwerte_8h_afa416e7460cf043207be351d750b97fe}\label{update__messwerte_8h_afa416e7460cf043207be351d750b97fe}} 
\index{update\+\_\+messwerte.\+h@{update\+\_\+messwerte.\+h}!hum\+\_\+erde\+\_\+1\+\_\+adc@{hum\+\_\+erde\+\_\+1\+\_\+adc}}
\index{hum\+\_\+erde\+\_\+1\+\_\+adc@{hum\+\_\+erde\+\_\+1\+\_\+adc}!update\+\_\+messwerte.\+h@{update\+\_\+messwerte.\+h}}
\subsubsection{\texorpdfstring{hum\+\_\+erde\+\_\+1\+\_\+adc}{hum\_erde\_1\_adc}}
{\footnotesize\ttfamily int hum\+\_\+erde\+\_\+1\+\_\+adc}

Definiert in Zeile 46 der Datei abschlussprojekt.\+c.

\mbox{\Hypertarget{update__messwerte_8h_aacdbec939adcfa404b8c42b2e064b110}\label{update__messwerte_8h_aacdbec939adcfa404b8c42b2e064b110}} 
\index{update\+\_\+messwerte.\+h@{update\+\_\+messwerte.\+h}!hum\+\_\+erde\+\_\+2\+\_\+adc@{hum\+\_\+erde\+\_\+2\+\_\+adc}}
\index{hum\+\_\+erde\+\_\+2\+\_\+adc@{hum\+\_\+erde\+\_\+2\+\_\+adc}!update\+\_\+messwerte.\+h@{update\+\_\+messwerte.\+h}}
\subsubsection{\texorpdfstring{hum\+\_\+erde\+\_\+2\+\_\+adc}{hum\_erde\_2\_adc}}
{\footnotesize\ttfamily int hum\+\_\+erde\+\_\+2\+\_\+adc}

Definiert in Zeile 47 der Datei abschlussprojekt.\+c.

\mbox{\Hypertarget{update__messwerte_8h_ac9fcb87eca48e4002731015e004966ef}\label{update__messwerte_8h_ac9fcb87eca48e4002731015e004966ef}} 
\index{update\+\_\+messwerte.\+h@{update\+\_\+messwerte.\+h}!hum\+\_\+luft@{hum\+\_\+luft}}
\index{hum\+\_\+luft@{hum\+\_\+luft}!update\+\_\+messwerte.\+h@{update\+\_\+messwerte.\+h}}
\subsubsection{\texorpdfstring{hum\+\_\+luft}{hum\_luft}}
{\footnotesize\ttfamily int hum\+\_\+luft}

Definiert in Zeile 48 der Datei abschlussprojekt.\+c.

\mbox{\Hypertarget{update__messwerte_8h_a0e6f058da75dead800f4a33e63586703}\label{update__messwerte_8h_a0e6f058da75dead800f4a33e63586703}} 
\index{update\+\_\+messwerte.\+h@{update\+\_\+messwerte.\+h}!temp\+\_\+luft\+\_\+C@{temp\+\_\+luft\+\_\+C}}
\index{temp\+\_\+luft\+\_\+C@{temp\+\_\+luft\+\_\+C}!update\+\_\+messwerte.\+h@{update\+\_\+messwerte.\+h}}
\subsubsection{\texorpdfstring{temp\+\_\+luft\+\_\+C}{temp\_luft\_C}}
{\footnotesize\ttfamily int temp\+\_\+luft\+\_\+C}

Definiert in Zeile 49 der Datei abschlussprojekt.\+c.
