robotron10/project_x/doxygen/latex/abschlussprojekt_8c__incl.pdf

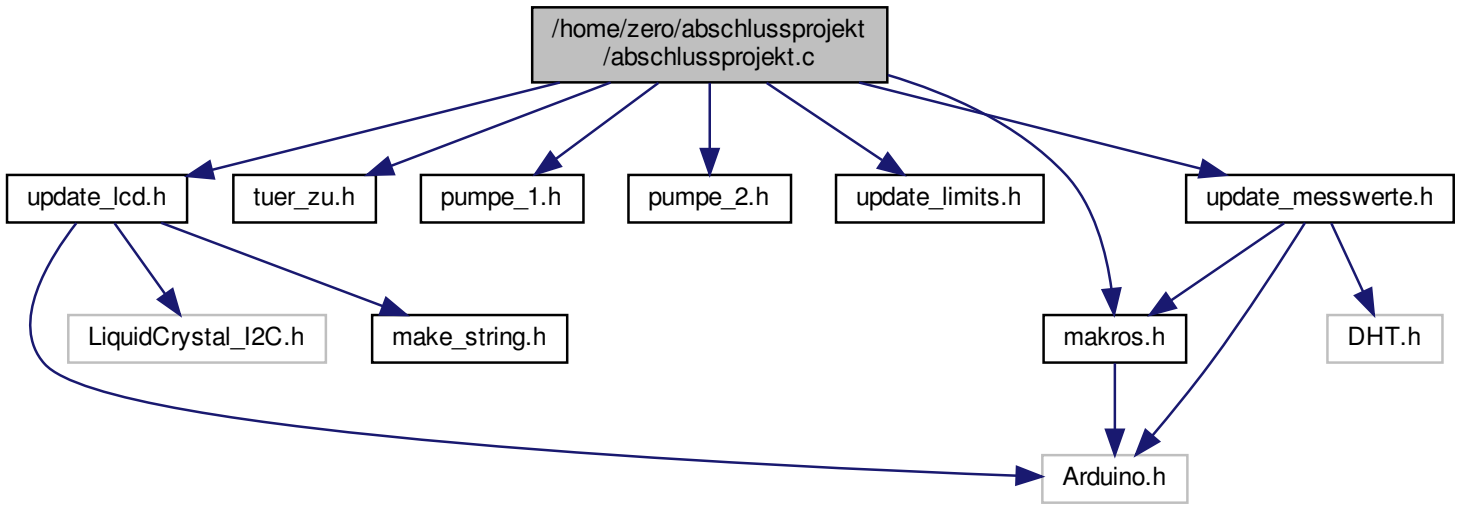
[picture p27: figure]
/home/zero/abschlussprojekt /abschlussprojekt.c; makros.h; update_lcd.h; tuer_zu.h; pumpe_1.h; pumpe_2.h; update_limits.h; update_messwerte.h; Arduino.h; LiquidCrystal_I2C.h; make_string.h; DHT.h
