robotron10/project_x/doxygen/latex/makros_8h__dep__incl.pdf

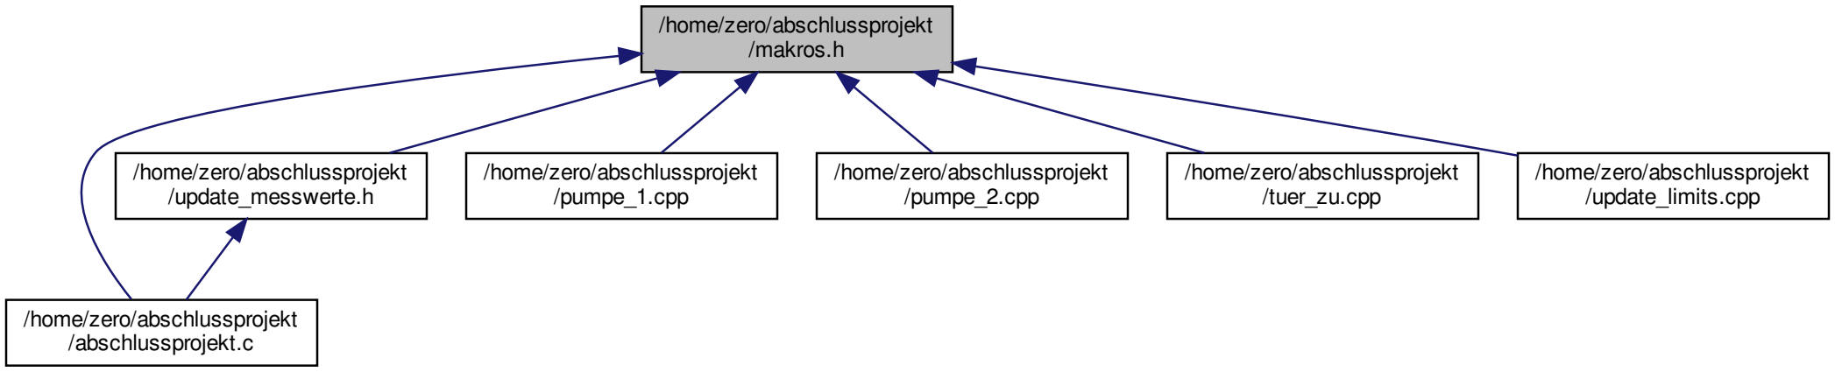
[picture p28: figure]
/home/zero/abschlussprojekt /makros.h; /home/zero/abschlussprojekt /abschlussprojekt.c; /home/zero/abschlussprojekt /update_messwerte.h; /home/zero/abschlussprojekt /pumpe_1.cpp; /home/zero/abschlussprojekt /pumpe_2.cpp; /home/zero/abschlussprojekt /tuer_zu.cpp; /home/zero/abschlussprojekt /update_limits.cpp
