robotron10/project_x/doxygen/latex/makros_8h__incl.pdf

/home/zero/abschlussprojekt /makros.h

Arduino.h
