robotron10/project_x/doxygen/latex/pumpe__1_8cpp__incl.pdf

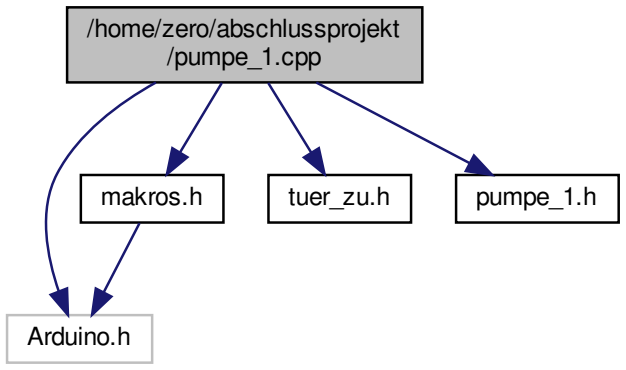
[picture p29: figure]
/home/zero/abschlussprojekt /pumpe_1.cpp; Arduino.h; makros.h; tuer_zu.h; pumpe_1.h
