robotron10/project_x/doxygen/latex/pumpe__1_8h__dep__incl.pdf

/home/zero/abschlussprojekt /pumpe_1.h

/home/zero/abschlussprojekt /abschlussprojekt.c

/home/zero/abschlussprojekt /pumpe_1.cpp
