robotron10/project_x/doxygen/latex/pumpe__2_8cpp__incl.pdf

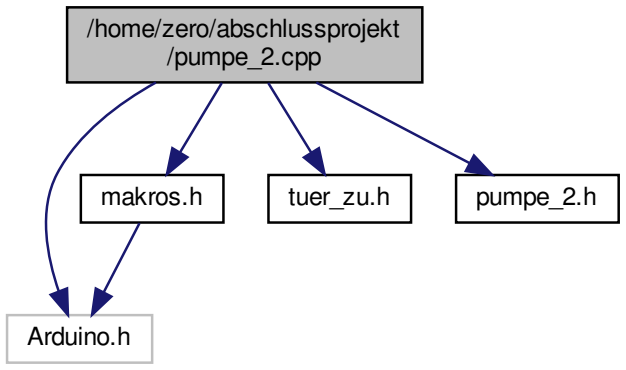
[picture p30: figure]
/home/zero/abschlussprojekt /pumpe_2.cpp; Arduino.h; makros.h; tuer_zu.h; pumpe_2.h
