robotron10/project_x/doxygen/latex/pumpe__2_8h__dep__incl.pdf

/home/zero/abschlussprojekt /pumpe_2.h

/home/zero/abschlussprojekt /abschlussprojekt.c

/home/zero/abschlussprojekt /pumpe_2.cpp
