robotron10/project_x/doxygen/latex/tuer__zu_8cpp__incl.pdf

/home/zero/abschlussprojekt /tuer_zu.cpp

Arduino.h

makros.h tuer_zu.h
