robotron10/project_x/doxygen/latex/tuer__zu_8h__dep__incl.pdf

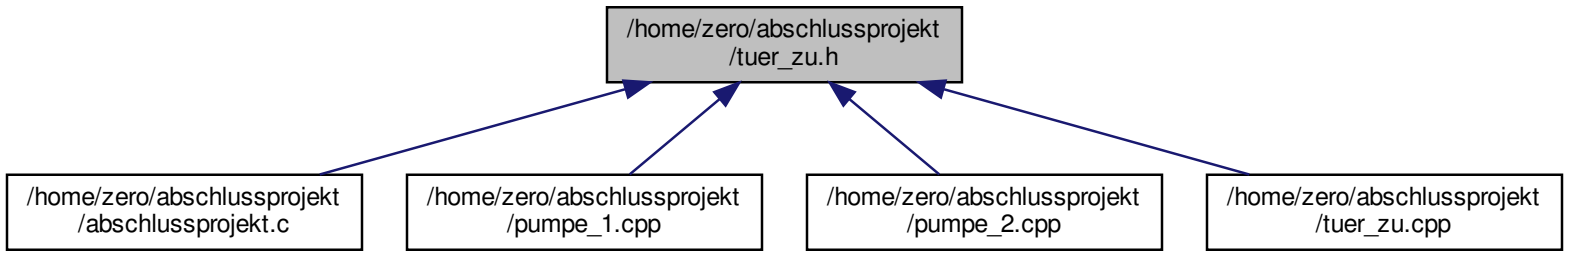
[picture p31: figure]
/home/zero/abschlussprojekt /tuer_zu.h; /home/zero/abschlussprojekt /abschlussprojekt.c; /home/zero/abschlussprojekt /pumpe_1.cpp; /home/zero/abschlussprojekt /pumpe_2.cpp; /home/zero/abschlussprojekt /tuer_zu.cpp
