robotron10/project_x/doxygen/latex/update__lcd_8h__incl.pdf

/home/zero/abschlussprojekt /update_lcd.h

Arduino.h | LiquidCrystal_I2C.h | make_string.h
