robotron10/project_x/doxygen/latex/update__limits_8cpp__incl.pdf

/home/zero/abschlussprojekt /update_limits.cpp

Arduino.h

makros.h update_limits.h
