robotron10/project_x/doxygen/latex/update__messwerte_8h__incl.pdf

/home/zero/abschlussprojekt /update_messwerte.h

Arduino.h

makros.h DHT.h
