robotron10/project_x/doxygen/latex/makros_8h.tex

\hypertarget{makros_8h}{}\section{/home/zero/abschlussprojekt/makros.h-\/\+Dateireferenz}
\label{makros_8h}\index{/home/zero/abschlussprojekt/makros.\+h@{/home/zero/abschlussprojekt/makros.\+h}}
{\ttfamily \#include $<$Arduino.\+h$>$}\newline
Include-\/\+Abhängigkeitsdiagramm für makros.\+h\+:
\nopagebreak
\begin{figure}[H]
\begin{center}
\leavevmode
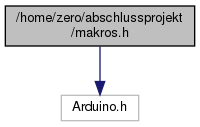
[picture p32: doxygen/html/makros_8h__incl.png]

\end{center}
\end{figure}
Dieser Graph zeigt, welche Datei direkt oder indirekt diese Datei enthält\+:
\nopagebreak
\begin{figure}[H]
\begin{center}
\leavevmode
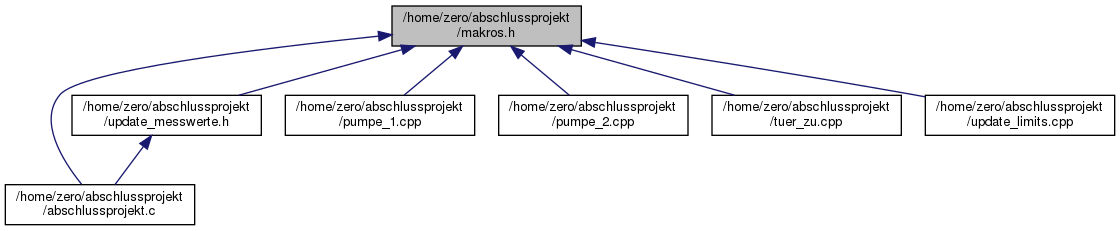
[picture p33: doxygen/html/makros_8h__dep__incl.png]

\end{center}
\end{figure}
\subsection*{Makrodefinitionen}
\begin{DoxyCompactItemize}
\item 
\#define \hyperlink{makros_8h_a2c509dba12bba99883a5be9341b7a0c5}{D\+H\+T\+T\+Y\+PE}~D\+H\+T22
\item 
\#define \hyperlink{makros_8h_a3edd9adbe80cfa6949a85935a79275d7}{T\+A\+S\+T\+E\+R\+\_\+\+D\+I\+S\+P\+L\+AY}~2
\item 
\#define \hyperlink{makros_8h_ae5585e7e3d65edaff2d78517eb4f759d}{R\+E\+L\+A\+I\+S\+\_\+\+P\+U\+M\+P\+E\+\_\+\+O\+B\+EN}~4
\item 
\#define \hyperlink{makros_8h_a2f5672d9a8ae3f2d5a148adbb8143c68}{R\+E\+L\+A\+I\+S\+\_\+\+P\+U\+M\+P\+E\+\_\+\+U\+N\+T\+EN}~5
\item 
\#define \hyperlink{makros_8h_a30d6fbf03c0e3ae5cf71977fe9dfa1d5}{R\+E\+L\+A\+I\+S\+\_\+\+L\+U\+E\+F\+T\+ER}~6
\item 
\#define \hyperlink{makros_8h_a5316bb60c0bf0c793c28ba8815caa69b}{R\+E\+L\+A\+I\+S\+\_\+\+U\+V\+\_\+\+L\+ED}~7
\item 
\#define \hyperlink{makros_8h_a2fc336b6f27547c3b2f8e501806d95e2}{R\+E\+L\+A\+I\+S\+\_\+\+H\+E\+I\+Z\+U\+NG}~8
\item 
\#define \hyperlink{makros_8h_a9894c05769fdf48b3506408030591a65}{T\+E\+M\+P\+E\+R\+A\+T\+U\+R\+S\+E\+N\+S\+O\+R\+\_\+\+L\+U\+E\+F\+T\+ER}~9
\item 
\#define \hyperlink{makros_8h_abd1dbbe0460847d74097b3fbb78d9457}{H\+E\+L\+L\+I\+G\+K\+E\+I\+T\+S\+S\+E\+N\+S\+OR}~10
\item 
\#define \hyperlink{makros_8h_aa5c8a88c5a3dde80789f0b329b877a6f}{R\+E\+E\+D\+K\+O\+N\+T\+A\+KT}~11
\item 
\#define \hyperlink{makros_8h_a217a0b1523cc63a0e9618b0b9bcc3944}{E\+R\+D\+F\+E\+U\+C\+H\+T\+E\+S\+E\+N\+S\+O\+R\+\_\+1}~A0
\item 
\#define \hyperlink{makros_8h_ab35f6b04d1873122637b48a378828072}{E\+R\+D\+F\+E\+U\+C\+H\+T\+E\+S\+E\+N\+S\+O\+R\+\_\+2}~A1
\item 
\#define \hyperlink{makros_8h_a2cfb9232ef93fe3dbe489ea0ed78ab5c}{L\+I\+M\+I\+T\+\_\+\+E\+R\+D\+F\+E\+U\+C\+H\+T\+E\+\_\+1}~A2
\item 
\#define \hyperlink{makros_8h_a06863b5c4eac468b904afed8c6c36440}{L\+I\+M\+I\+T\+\_\+\+E\+R\+D\+F\+E\+U\+C\+H\+T\+E\+\_\+2}~A3
\item 
\#define \hyperlink{makros_8h_ae07fe35374a1fd6e6d921bd39ba73b99}{L\+I\+M\+I\+T\+\_\+\+T\+E\+M\+P\+E\+R\+A\+T\+UR}~A6
\item 
\#define \hyperlink{makros_8h_a392b9a22bb52d29603ffb57ab4255e86}{L\+I\+M\+I\+T\+\_\+\+L\+U\+E\+F\+T\+ER}~A5
\item 
\#define \hyperlink{makros_8h_acd99f73b20037e5fcba7a4a031e0f320}{zustand\+\_\+warten\+\_\+zu\+\_\+trocken}~0
\item 
\#define \hyperlink{makros_8h_a451a24326bd3759cea1cbd0da8d4bb12}{zustand\+\_\+pumpt}~1
\item 
\#define \hyperlink{makros_8h_a15e9e3e52a86bfb566502710f2453c20}{zustand\+\_\+warten\+\_\+durchfeuchtung}~2
\end{DoxyCompactItemize}

\subsection{Makro-\/\+Dokumentation}
\mbox{\Hypertarget{makros_8h_a2c509dba12bba99883a5be9341b7a0c5}\label{makros_8h_a2c509dba12bba99883a5be9341b7a0c5}} 
\index{makros.\+h@{makros.\+h}!D\+H\+T\+T\+Y\+PE@{D\+H\+T\+T\+Y\+PE}}
\index{D\+H\+T\+T\+Y\+PE@{D\+H\+T\+T\+Y\+PE}!makros.\+h@{makros.\+h}}
\subsubsection{\texorpdfstring{D\+H\+T\+T\+Y\+PE}{DHTTYPE}}
{\footnotesize\ttfamily \#define D\+H\+T\+T\+Y\+PE~D\+H\+T22}

Definiert in Zeile 8 der Datei makros.\+h.

\mbox{\Hypertarget{makros_8h_a217a0b1523cc63a0e9618b0b9bcc3944}\label{makros_8h_a217a0b1523cc63a0e9618b0b9bcc3944}} 
\index{makros.\+h@{makros.\+h}!E\+R\+D\+F\+E\+U\+C\+H\+T\+E\+S\+E\+N\+S\+O\+R\+\_\+1@{E\+R\+D\+F\+E\+U\+C\+H\+T\+E\+S\+E\+N\+S\+O\+R\+\_\+1}}
\index{E\+R\+D\+F\+E\+U\+C\+H\+T\+E\+S\+E\+N\+S\+O\+R\+\_\+1@{E\+R\+D\+F\+E\+U\+C\+H\+T\+E\+S\+E\+N\+S\+O\+R\+\_\+1}!makros.\+h@{makros.\+h}}
\subsubsection{\texorpdfstring{E\+R\+D\+F\+E\+U\+C\+H\+T\+E\+S\+E\+N\+S\+O\+R\+\_\+1}{ERDFEUCHTESENSOR\_1}}
{\footnotesize\ttfamily \#define E\+R\+D\+F\+E\+U\+C\+H\+T\+E\+S\+E\+N\+S\+O\+R\+\_\+1~A0}

Definiert in Zeile 20 der Datei makros.\+h.

\mbox{\Hypertarget{makros_8h_ab35f6b04d1873122637b48a378828072}\label{makros_8h_ab35f6b04d1873122637b48a378828072}} 
\index{makros.\+h@{makros.\+h}!E\+R\+D\+F\+E\+U\+C\+H\+T\+E\+S\+E\+N\+S\+O\+R\+\_\+2@{E\+R\+D\+F\+E\+U\+C\+H\+T\+E\+S\+E\+N\+S\+O\+R\+\_\+2}}
\index{E\+R\+D\+F\+E\+U\+C\+H\+T\+E\+S\+E\+N\+S\+O\+R\+\_\+2@{E\+R\+D\+F\+E\+U\+C\+H\+T\+E\+S\+E\+N\+S\+O\+R\+\_\+2}!makros.\+h@{makros.\+h}}
\subsubsection{\texorpdfstring{E\+R\+D\+F\+E\+U\+C\+H\+T\+E\+S\+E\+N\+S\+O\+R\+\_\+2}{ERDFEUCHTESENSOR\_2}}
{\footnotesize\ttfamily \#define E\+R\+D\+F\+E\+U\+C\+H\+T\+E\+S\+E\+N\+S\+O\+R\+\_\+2~A1}

Definiert in Zeile 21 der Datei makros.\+h.

\mbox{\Hypertarget{makros_8h_abd1dbbe0460847d74097b3fbb78d9457}\label{makros_8h_abd1dbbe0460847d74097b3fbb78d9457}} 
\index{makros.\+h@{makros.\+h}!H\+E\+L\+L\+I\+G\+K\+E\+I\+T\+S\+S\+E\+N\+S\+OR@{H\+E\+L\+L\+I\+G\+K\+E\+I\+T\+S\+S\+E\+N\+S\+OR}}
\index{H\+E\+L\+L\+I\+G\+K\+E\+I\+T\+S\+S\+E\+N\+S\+OR@{H\+E\+L\+L\+I\+G\+K\+E\+I\+T\+S\+S\+E\+N\+S\+OR}!makros.\+h@{makros.\+h}}
\subsubsection{\texorpdfstring{H\+E\+L\+L\+I\+G\+K\+E\+I\+T\+S\+S\+E\+N\+S\+OR}{HELLIGKEITSSENSOR}}
{\footnotesize\ttfamily \#define H\+E\+L\+L\+I\+G\+K\+E\+I\+T\+S\+S\+E\+N\+S\+OR~10}

Definiert in Zeile 16 der Datei makros.\+h.

\mbox{\Hypertarget{makros_8h_a2cfb9232ef93fe3dbe489ea0ed78ab5c}\label{makros_8h_a2cfb9232ef93fe3dbe489ea0ed78ab5c}} 
\index{makros.\+h@{makros.\+h}!L\+I\+M\+I\+T\+\_\+\+E\+R\+D\+F\+E\+U\+C\+H\+T\+E\+\_\+1@{L\+I\+M\+I\+T\+\_\+\+E\+R\+D\+F\+E\+U\+C\+H\+T\+E\+\_\+1}}
\index{L\+I\+M\+I\+T\+\_\+\+E\+R\+D\+F\+E\+U\+C\+H\+T\+E\+\_\+1@{L\+I\+M\+I\+T\+\_\+\+E\+R\+D\+F\+E\+U\+C\+H\+T\+E\+\_\+1}!makros.\+h@{makros.\+h}}
\subsubsection{\texorpdfstring{L\+I\+M\+I\+T\+\_\+\+E\+R\+D\+F\+E\+U\+C\+H\+T\+E\+\_\+1}{LIMIT\_ERDFEUCHTE\_1}}
{\footnotesize\ttfamily \#define L\+I\+M\+I\+T\+\_\+\+E\+R\+D\+F\+E\+U\+C\+H\+T\+E\+\_\+1~A2}

Definiert in Zeile 22 der Datei makros.\+h.

\mbox{\Hypertarget{makros_8h_a06863b5c4eac468b904afed8c6c36440}\label{makros_8h_a06863b5c4eac468b904afed8c6c36440}} 
\index{makros.\+h@{makros.\+h}!L\+I\+M\+I\+T\+\_\+\+E\+R\+D\+F\+E\+U\+C\+H\+T\+E\+\_\+2@{L\+I\+M\+I\+T\+\_\+\+E\+R\+D\+F\+E\+U\+C\+H\+T\+E\+\_\+2}}
\index{L\+I\+M\+I\+T\+\_\+\+E\+R\+D\+F\+E\+U\+C\+H\+T\+E\+\_\+2@{L\+I\+M\+I\+T\+\_\+\+E\+R\+D\+F\+E\+U\+C\+H\+T\+E\+\_\+2}!makros.\+h@{makros.\+h}}
\subsubsection{\texorpdfstring{L\+I\+M\+I\+T\+\_\+\+E\+R\+D\+F\+E\+U\+C\+H\+T\+E\+\_\+2}{LIMIT\_ERDFEUCHTE\_2}}
{\footnotesize\ttfamily \#define L\+I\+M\+I\+T\+\_\+\+E\+R\+D\+F\+E\+U\+C\+H\+T\+E\+\_\+2~A3}

Definiert in Zeile 23 der Datei makros.\+h.

\mbox{\Hypertarget{makros_8h_a392b9a22bb52d29603ffb57ab4255e86}\label{makros_8h_a392b9a22bb52d29603ffb57ab4255e86}} 
\index{makros.\+h@{makros.\+h}!L\+I\+M\+I\+T\+\_\+\+L\+U\+E\+F\+T\+ER@{L\+I\+M\+I\+T\+\_\+\+L\+U\+E\+F\+T\+ER}}
\index{L\+I\+M\+I\+T\+\_\+\+L\+U\+E\+F\+T\+ER@{L\+I\+M\+I\+T\+\_\+\+L\+U\+E\+F\+T\+ER}!makros.\+h@{makros.\+h}}
\subsubsection{\texorpdfstring{L\+I\+M\+I\+T\+\_\+\+L\+U\+E\+F\+T\+ER}{LIMIT\_LUEFTER}}
{\footnotesize\ttfamily \#define L\+I\+M\+I\+T\+\_\+\+L\+U\+E\+F\+T\+ER~A5}

Definiert in Zeile 25 der Datei makros.\+h.

\mbox{\Hypertarget{makros_8h_ae07fe35374a1fd6e6d921bd39ba73b99}\label{makros_8h_ae07fe35374a1fd6e6d921bd39ba73b99}} 
\index{makros.\+h@{makros.\+h}!L\+I\+M\+I\+T\+\_\+\+T\+E\+M\+P\+E\+R\+A\+T\+UR@{L\+I\+M\+I\+T\+\_\+\+T\+E\+M\+P\+E\+R\+A\+T\+UR}}
\index{L\+I\+M\+I\+T\+\_\+\+T\+E\+M\+P\+E\+R\+A\+T\+UR@{L\+I\+M\+I\+T\+\_\+\+T\+E\+M\+P\+E\+R\+A\+T\+UR}!makros.\+h@{makros.\+h}}
\subsubsection{\texorpdfstring{L\+I\+M\+I\+T\+\_\+\+T\+E\+M\+P\+E\+R\+A\+T\+UR}{LIMIT\_TEMPERATUR}}
{\footnotesize\ttfamily \#define L\+I\+M\+I\+T\+\_\+\+T\+E\+M\+P\+E\+R\+A\+T\+UR~A6}

Definiert in Zeile 24 der Datei makros.\+h.

\mbox{\Hypertarget{makros_8h_aa5c8a88c5a3dde80789f0b329b877a6f}\label{makros_8h_aa5c8a88c5a3dde80789f0b329b877a6f}} 
\index{makros.\+h@{makros.\+h}!R\+E\+E\+D\+K\+O\+N\+T\+A\+KT@{R\+E\+E\+D\+K\+O\+N\+T\+A\+KT}}
\index{R\+E\+E\+D\+K\+O\+N\+T\+A\+KT@{R\+E\+E\+D\+K\+O\+N\+T\+A\+KT}!makros.\+h@{makros.\+h}}
\subsubsection{\texorpdfstring{R\+E\+E\+D\+K\+O\+N\+T\+A\+KT}{REEDKONTAKT}}
{\footnotesize\ttfamily \#define R\+E\+E\+D\+K\+O\+N\+T\+A\+KT~11}

Definiert in Zeile 17 der Datei makros.\+h.

\mbox{\Hypertarget{makros_8h_a2fc336b6f27547c3b2f8e501806d95e2}\label{makros_8h_a2fc336b6f27547c3b2f8e501806d95e2}} 
\index{makros.\+h@{makros.\+h}!R\+E\+L\+A\+I\+S\+\_\+\+H\+E\+I\+Z\+U\+NG@{R\+E\+L\+A\+I\+S\+\_\+\+H\+E\+I\+Z\+U\+NG}}
\index{R\+E\+L\+A\+I\+S\+\_\+\+H\+E\+I\+Z\+U\+NG@{R\+E\+L\+A\+I\+S\+\_\+\+H\+E\+I\+Z\+U\+NG}!makros.\+h@{makros.\+h}}
\subsubsection{\texorpdfstring{R\+E\+L\+A\+I\+S\+\_\+\+H\+E\+I\+Z\+U\+NG}{RELAIS\_HEIZUNG}}
{\footnotesize\ttfamily \#define R\+E\+L\+A\+I\+S\+\_\+\+H\+E\+I\+Z\+U\+NG~8}

Definiert in Zeile 14 der Datei makros.\+h.

\mbox{\Hypertarget{makros_8h_a30d6fbf03c0e3ae5cf71977fe9dfa1d5}\label{makros_8h_a30d6fbf03c0e3ae5cf71977fe9dfa1d5}} 
\index{makros.\+h@{makros.\+h}!R\+E\+L\+A\+I\+S\+\_\+\+L\+U\+E\+F\+T\+ER@{R\+E\+L\+A\+I\+S\+\_\+\+L\+U\+E\+F\+T\+ER}}
\index{R\+E\+L\+A\+I\+S\+\_\+\+L\+U\+E\+F\+T\+ER@{R\+E\+L\+A\+I\+S\+\_\+\+L\+U\+E\+F\+T\+ER}!makros.\+h@{makros.\+h}}
\subsubsection{\texorpdfstring{R\+E\+L\+A\+I\+S\+\_\+\+L\+U\+E\+F\+T\+ER}{RELAIS\_LUEFTER}}
{\footnotesize\ttfamily \#define R\+E\+L\+A\+I\+S\+\_\+\+L\+U\+E\+F\+T\+ER~6}

Definiert in Zeile 12 der Datei makros.\+h.

\mbox{\Hypertarget{makros_8h_ae5585e7e3d65edaff2d78517eb4f759d}\label{makros_8h_ae5585e7e3d65edaff2d78517eb4f759d}} 
\index{makros.\+h@{makros.\+h}!R\+E\+L\+A\+I\+S\+\_\+\+P\+U\+M\+P\+E\+\_\+\+O\+B\+EN@{R\+E\+L\+A\+I\+S\+\_\+\+P\+U\+M\+P\+E\+\_\+\+O\+B\+EN}}
\index{R\+E\+L\+A\+I\+S\+\_\+\+P\+U\+M\+P\+E\+\_\+\+O\+B\+EN@{R\+E\+L\+A\+I\+S\+\_\+\+P\+U\+M\+P\+E\+\_\+\+O\+B\+EN}!makros.\+h@{makros.\+h}}
\subsubsection{\texorpdfstring{R\+E\+L\+A\+I\+S\+\_\+\+P\+U\+M\+P\+E\+\_\+\+O\+B\+EN}{RELAIS\_PUMPE\_OBEN}}
{\footnotesize\ttfamily \#define R\+E\+L\+A\+I\+S\+\_\+\+P\+U\+M\+P\+E\+\_\+\+O\+B\+EN~4}

Definiert in Zeile 10 der Datei makros.\+h.

\mbox{\Hypertarget{makros_8h_a2f5672d9a8ae3f2d5a148adbb8143c68}\label{makros_8h_a2f5672d9a8ae3f2d5a148adbb8143c68}} 
\index{makros.\+h@{makros.\+h}!R\+E\+L\+A\+I\+S\+\_\+\+P\+U\+M\+P\+E\+\_\+\+U\+N\+T\+EN@{R\+E\+L\+A\+I\+S\+\_\+\+P\+U\+M\+P\+E\+\_\+\+U\+N\+T\+EN}}
\index{R\+E\+L\+A\+I\+S\+\_\+\+P\+U\+M\+P\+E\+\_\+\+U\+N\+T\+EN@{R\+E\+L\+A\+I\+S\+\_\+\+P\+U\+M\+P\+E\+\_\+\+U\+N\+T\+EN}!makros.\+h@{makros.\+h}}
\subsubsection{\texorpdfstring{R\+E\+L\+A\+I\+S\+\_\+\+P\+U\+M\+P\+E\+\_\+\+U\+N\+T\+EN}{RELAIS\_PUMPE\_UNTEN}}
{\footnotesize\ttfamily \#define R\+E\+L\+A\+I\+S\+\_\+\+P\+U\+M\+P\+E\+\_\+\+U\+N\+T\+EN~5}

Definiert in Zeile 11 der Datei makros.\+h.

\mbox{\Hypertarget{makros_8h_a5316bb60c0bf0c793c28ba8815caa69b}\label{makros_8h_a5316bb60c0bf0c793c28ba8815caa69b}} 
\index{makros.\+h@{makros.\+h}!R\+E\+L\+A\+I\+S\+\_\+\+U\+V\+\_\+\+L\+ED@{R\+E\+L\+A\+I\+S\+\_\+\+U\+V\+\_\+\+L\+ED}}
\index{R\+E\+L\+A\+I\+S\+\_\+\+U\+V\+\_\+\+L\+ED@{R\+E\+L\+A\+I\+S\+\_\+\+U\+V\+\_\+\+L\+ED}!makros.\+h@{makros.\+h}}
\subsubsection{\texorpdfstring{R\+E\+L\+A\+I\+S\+\_\+\+U\+V\+\_\+\+L\+ED}{RELAIS\_UV\_LED}}
{\footnotesize\ttfamily \#define R\+E\+L\+A\+I\+S\+\_\+\+U\+V\+\_\+\+L\+ED~7}

Definiert in Zeile 13 der Datei makros.\+h.

\mbox{\Hypertarget{makros_8h_a3edd9adbe80cfa6949a85935a79275d7}\label{makros_8h_a3edd9adbe80cfa6949a85935a79275d7}} 
\index{makros.\+h@{makros.\+h}!T\+A\+S\+T\+E\+R\+\_\+\+D\+I\+S\+P\+L\+AY@{T\+A\+S\+T\+E\+R\+\_\+\+D\+I\+S\+P\+L\+AY}}
\index{T\+A\+S\+T\+E\+R\+\_\+\+D\+I\+S\+P\+L\+AY@{T\+A\+S\+T\+E\+R\+\_\+\+D\+I\+S\+P\+L\+AY}!makros.\+h@{makros.\+h}}
\subsubsection{\texorpdfstring{T\+A\+S\+T\+E\+R\+\_\+\+D\+I\+S\+P\+L\+AY}{TASTER\_DISPLAY}}
{\footnotesize\ttfamily \#define T\+A\+S\+T\+E\+R\+\_\+\+D\+I\+S\+P\+L\+AY~2}

Definiert in Zeile 9 der Datei makros.\+h.

\mbox{\Hypertarget{makros_8h_a9894c05769fdf48b3506408030591a65}\label{makros_8h_a9894c05769fdf48b3506408030591a65}} 
\index{makros.\+h@{makros.\+h}!T\+E\+M\+P\+E\+R\+A\+T\+U\+R\+S\+E\+N\+S\+O\+R\+\_\+\+L\+U\+E\+F\+T\+ER@{T\+E\+M\+P\+E\+R\+A\+T\+U\+R\+S\+E\+N\+S\+O\+R\+\_\+\+L\+U\+E\+F\+T\+ER}}
\index{T\+E\+M\+P\+E\+R\+A\+T\+U\+R\+S\+E\+N\+S\+O\+R\+\_\+\+L\+U\+E\+F\+T\+ER@{T\+E\+M\+P\+E\+R\+A\+T\+U\+R\+S\+E\+N\+S\+O\+R\+\_\+\+L\+U\+E\+F\+T\+ER}!makros.\+h@{makros.\+h}}
\subsubsection{\texorpdfstring{T\+E\+M\+P\+E\+R\+A\+T\+U\+R\+S\+E\+N\+S\+O\+R\+\_\+\+L\+U\+E\+F\+T\+ER}{TEMPERATURSENSOR\_LUEFTER}}
{\footnotesize\ttfamily \#define T\+E\+M\+P\+E\+R\+A\+T\+U\+R\+S\+E\+N\+S\+O\+R\+\_\+\+L\+U\+E\+F\+T\+ER~9}

Definiert in Zeile 15 der Datei makros.\+h.

\mbox{\Hypertarget{makros_8h_a451a24326bd3759cea1cbd0da8d4bb12}\label{makros_8h_a451a24326bd3759cea1cbd0da8d4bb12}} 
\index{makros.\+h@{makros.\+h}!zustand\+\_\+pumpt@{zustand\+\_\+pumpt}}
\index{zustand\+\_\+pumpt@{zustand\+\_\+pumpt}!makros.\+h@{makros.\+h}}
\subsubsection{\texorpdfstring{zustand\+\_\+pumpt}{zustand\_pumpt}}
{\footnotesize\ttfamily \#define zustand\+\_\+pumpt~1}

Definiert in Zeile 29 der Datei makros.\+h.

\mbox{\Hypertarget{makros_8h_a15e9e3e52a86bfb566502710f2453c20}\label{makros_8h_a15e9e3e52a86bfb566502710f2453c20}} 
\index{makros.\+h@{makros.\+h}!zustand\+\_\+warten\+\_\+durchfeuchtung@{zustand\+\_\+warten\+\_\+durchfeuchtung}}
\index{zustand\+\_\+warten\+\_\+durchfeuchtung@{zustand\+\_\+warten\+\_\+durchfeuchtung}!makros.\+h@{makros.\+h}}
\subsubsection{\texorpdfstring{zustand\+\_\+warten\+\_\+durchfeuchtung}{zustand\_warten\_durchfeuchtung}}
{\footnotesize\ttfamily \#define zustand\+\_\+warten\+\_\+durchfeuchtung~2}

Definiert in Zeile 30 der Datei makros.\+h.

\mbox{\Hypertarget{makros_8h_acd99f73b20037e5fcba7a4a031e0f320}\label{makros_8h_acd99f73b20037e5fcba7a4a031e0f320}} 
\index{makros.\+h@{makros.\+h}!zustand\+\_\+warten\+\_\+zu\+\_\+trocken@{zustand\+\_\+warten\+\_\+zu\+\_\+trocken}}
\index{zustand\+\_\+warten\+\_\+zu\+\_\+trocken@{zustand\+\_\+warten\+\_\+zu\+\_\+trocken}!makros.\+h@{makros.\+h}}
\subsubsection{\texorpdfstring{zustand\+\_\+warten\+\_\+zu\+\_\+trocken}{zustand\_warten\_zu\_trocken}}
{\footnotesize\ttfamily \#define zustand\+\_\+warten\+\_\+zu\+\_\+trocken~0}

Definiert in Zeile 28 der Datei makros.\+h.
