robotron10/project_x/doxygen/latex/tuer__zu_8cpp.tex

\hypertarget{tuer__zu_8cpp}{}\section{/home/zero/abschlussprojekt/tuer\+\_\+zu.cpp-\/\+Dateireferenz}
\label{tuer__zu_8cpp}\index{/home/zero/abschlussprojekt/tuer\+\_\+zu.\+cpp@{/home/zero/abschlussprojekt/tuer\+\_\+zu.\+cpp}}
{\ttfamily \#include $<$Arduino.\+h$>$}\newline
{\ttfamily \#include \char`\"{}makros.\+h\char`\"{}}\newline
{\ttfamily \#include \char`\"{}tuer\+\_\+zu.\+h\char`\"{}}\newline
Include-\/\+Abhängigkeitsdiagramm für tuer\+\_\+zu.\+cpp\+:
\nopagebreak
\begin{figure}[H]
\begin{center}
\leavevmode
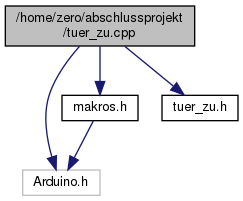
[picture p34: doxygen/html/tuer__zu_8cpp__incl.png]

\end{center}
\end{figure}
\subsection*{Funktionen}
\begin{DoxyCompactItemize}
\item 
bool \hyperlink{tuer__zu_8cpp_a204dcf18a43cbaf756753c4de7bc10b4}{tuer\+\_\+zu} ()
\begin{DoxyCompactList}\small\item\em Auswertung des R\+E\+E\+D-\/\+Kontaktes ///. \end{DoxyCompactList}\end{DoxyCompactItemize}

\subsection{Dokumentation der Funktionen}
\mbox{\Hypertarget{tuer__zu_8cpp_a204dcf18a43cbaf756753c4de7bc10b4}\label{tuer__zu_8cpp_a204dcf18a43cbaf756753c4de7bc10b4}} 
\index{tuer\+\_\+zu.\+cpp@{tuer\+\_\+zu.\+cpp}!tuer\+\_\+zu@{tuer\+\_\+zu}}
\index{tuer\+\_\+zu@{tuer\+\_\+zu}!tuer\+\_\+zu.\+cpp@{tuer\+\_\+zu.\+cpp}}
\subsubsection{\texorpdfstring{tuer\+\_\+zu()}{tuer\_zu()}}
{\footnotesize\ttfamily bool tuer\+\_\+zu (\begin{DoxyParamCaption}{ }\end{DoxyParamCaption})}

Auswertung des R\+E\+E\+D-\/\+Kontaktes ///. 

Definiert in Zeile 8 der Datei tuer\+\_\+zu.\+cpp.
