robotron10/project_x/doxygen/latex/tuer__zu_8h.tex

\hypertarget{tuer__zu_8h}{}\section{/home/zero/abschlussprojekt/tuer\+\_\+zu.h-\/\+Dateireferenz}
\label{tuer__zu_8h}\index{/home/zero/abschlussprojekt/tuer\+\_\+zu.\+h@{/home/zero/abschlussprojekt/tuer\+\_\+zu.\+h}}
Dieser Graph zeigt, welche Datei direkt oder indirekt diese Datei enthält\+:
\nopagebreak
\begin{figure}[H]
\begin{center}
\leavevmode

\end{center}
\end{figure}
\subsection*{Funktionen}
\begin{DoxyCompactItemize}
\item 
bool \hyperlink{tuer__zu_8h_a204dcf18a43cbaf756753c4de7bc10b4}{tuer\+\_\+zu} ()
\begin{DoxyCompactList}\small\item\em Auswertung des R\+E\+E\+D-\/\+Kontaktes ///. \end{DoxyCompactList}\end{DoxyCompactItemize}

\subsection{Dokumentation der Funktionen}
\mbox{\Hypertarget{tuer__zu_8h_a204dcf18a43cbaf756753c4de7bc10b4}\label{tuer__zu_8h_a204dcf18a43cbaf756753c4de7bc10b4}} 
\index{tuer\+\_\+zu.\+h@{tuer\+\_\+zu.\+h}!tuer\+\_\+zu@{tuer\+\_\+zu}}
\index{tuer\+\_\+zu@{tuer\+\_\+zu}!tuer\+\_\+zu.\+h@{tuer\+\_\+zu.\+h}}
\subsubsection{\texorpdfstring{tuer\+\_\+zu()}{tuer\_zu()}}
{\footnotesize\ttfamily bool tuer\+\_\+zu (\begin{DoxyParamCaption}{ }\end{DoxyParamCaption})}

Auswertung des R\+E\+E\+D-\/\+Kontaktes ///. 

Definiert in Zeile 8 der Datei tuer\+\_\+zu.\+cpp.
