robotron10/project_x/doxygen/latex/update__limits_8h.tex

\hypertarget{update__limits_8h}{}\section{/home/zero/abschlussprojekt/update\+\_\+limits.h-\/\+Dateireferenz}
\label{update__limits_8h}\index{/home/zero/abschlussprojekt/update\+\_\+limits.\+h@{/home/zero/abschlussprojekt/update\+\_\+limits.\+h}}
Dieser Graph zeigt, welche Datei direkt oder indirekt diese Datei enthält\+:
\nopagebreak
\begin{figure}[H]
\begin{center}
\leavevmode
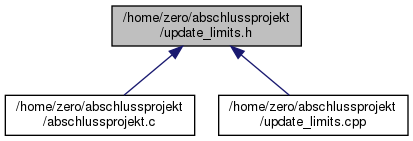
[picture p35: doxygen/html/update__limits_8h__dep__incl.png]

\end{center}
\end{figure}
\subsection*{Funktionen}
\begin{DoxyCompactItemize}
\item 
void \hyperlink{update__limits_8h_aa626307640ddc7baa35c92ff1713e6bb}{update\+\_\+limits} (void)
\begin{DoxyCompactList}\small\item\em aktualisieren der Schwellenwerte /// \end{DoxyCompactList}\end{DoxyCompactItemize}

\subsection{Dokumentation der Funktionen}
\mbox{\Hypertarget{update__limits_8h_aa626307640ddc7baa35c92ff1713e6bb}\label{update__limits_8h_aa626307640ddc7baa35c92ff1713e6bb}} 
\index{update\+\_\+limits.\+h@{update\+\_\+limits.\+h}!update\+\_\+limits@{update\+\_\+limits}}
\index{update\+\_\+limits@{update\+\_\+limits}!update\+\_\+limits.\+h@{update\+\_\+limits.\+h}}
\subsubsection{\texorpdfstring{update\+\_\+limits()}{update\_limits()}}
{\footnotesize\ttfamily void update\+\_\+limits (\begin{DoxyParamCaption}\item[{void}]{ }\end{DoxyParamCaption})}

aktualisieren der Schwellenwerte /// 

Definiert in Zeile 13 der Datei update\+\_\+limits.\+cpp.
