robotron10/project_x/datasheets/DC-DC_converter.jpg

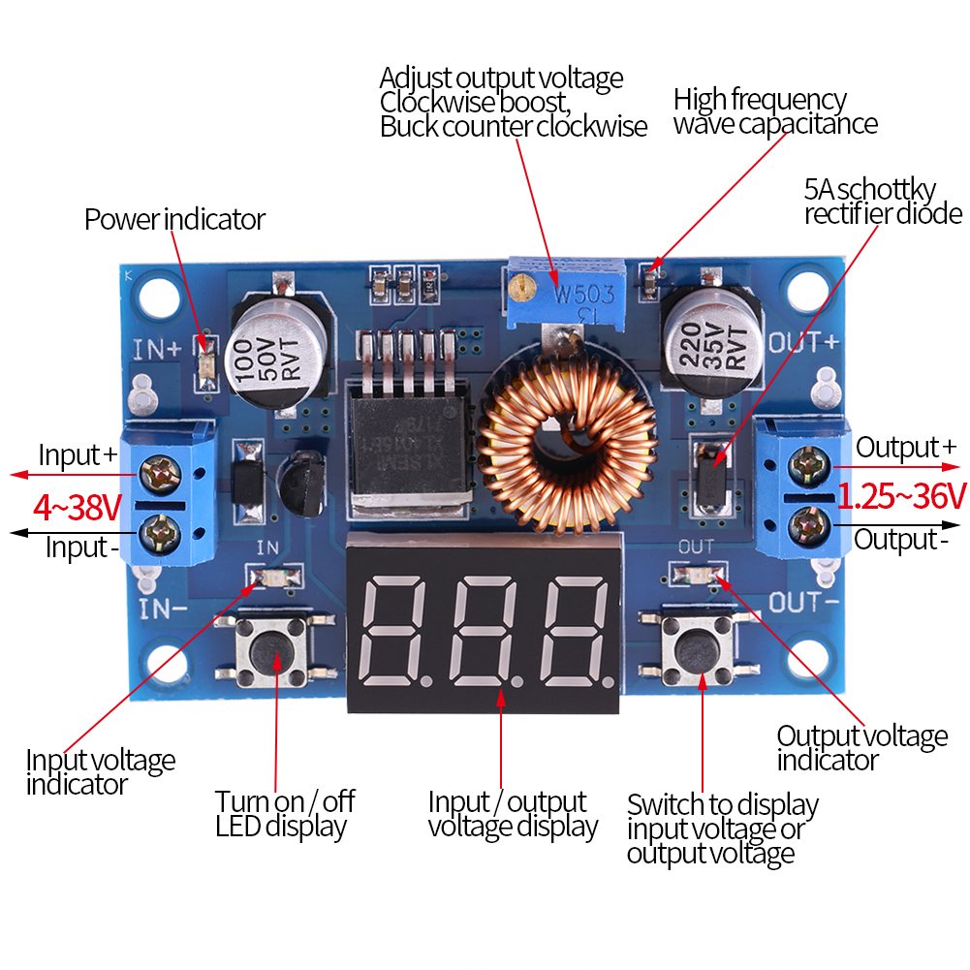
datasheets/DC-DC_converter.jpg
