robotron10/project_x/doxygen/2019_doxy1.png

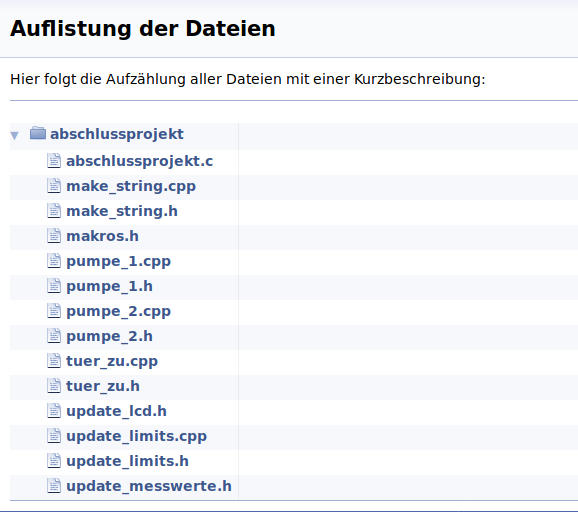
doxygen/2019_doxy1.png
