robotron10/project_x/doxygen/2019_doxy_funktionen.png

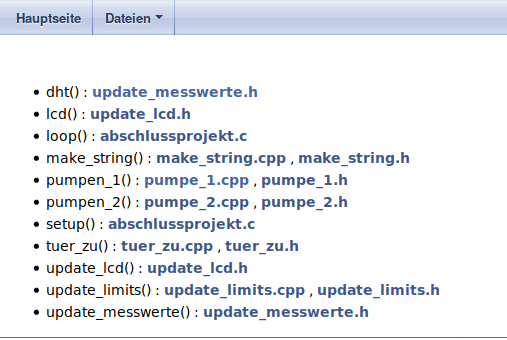
doxygen/2019_doxy_funktionen.png
