robotron10/project_x/doxygen/2019_doxy_makros.png

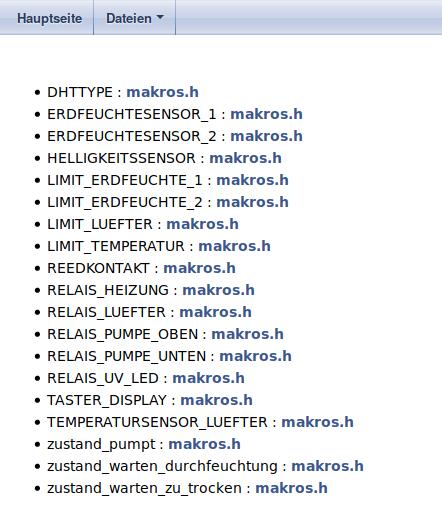
doxygen/2019_doxy_makros.png
