robotron10/project_x/Doku/Stueckliste.ods

Stückliste
Nr. | Artikel | Anzahl | Preis | Leistung
1 | Arduino Mega | 1
2 | DC-DC Spannungswandler | 1 | 8,69 | 5A
3 | Netzteil | 1 |  | 12V2,5A
4 | Relais Modul 4er | 2 |  | 5V
5 | Display 20x4 | 1 | 7,99 | 5V
6 | Temperatursensor DHT22 | 1 |  | 5V
7 | Helligkeitssensor | 1 |  | 5V
8 | Erdfeuchtesensor | 2 |  | 5V
9 | REED-Kontakt | 1
10 | Lüfter | 1 |  | 12V/0,11A
11 | Servomotor | 1 |  | 5V
12 | Wasserpumpe | 2
13 | LED-Licht | 1
14 | Drossel 100mH | 2
15 | Kondensator 47uF | 1
16 | Potentiometer 10k | 4
17 | Taster | 1
18 | ITEM-Profil
19 | PMMA-Platten | 6
20 | Scharniere | 2
21 | Griff (Klappe vorn) | 1
22 | Schläuche | 2
23 | Wanne | 1
24 | Schaltkasten
25 | Schrauben
26 | Muttern
27
28
29
30
31
32
