robotron10/project_x/librecad/aufbau/schematischer_aufbau_versorgung.dxf

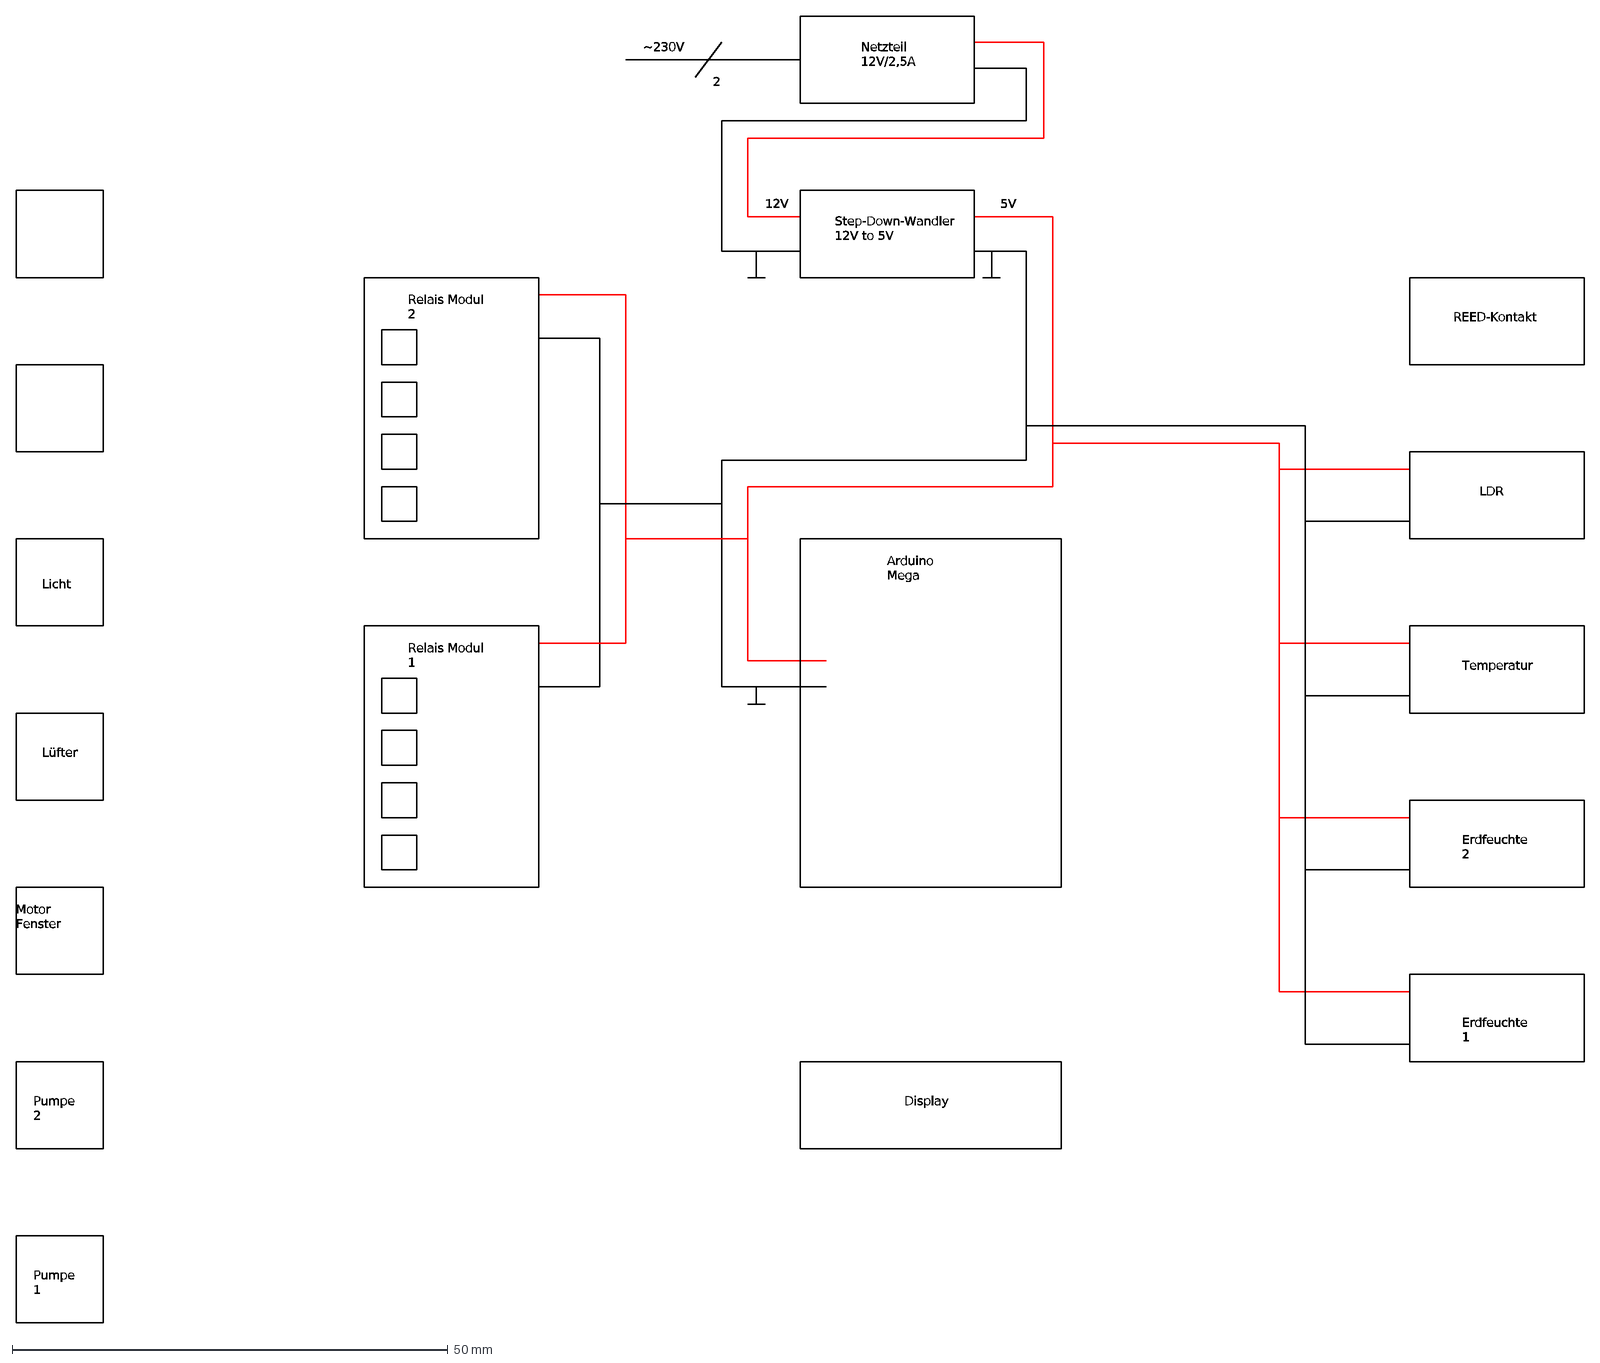
[picture p40: CAD file, 2019-08-07]
librecad/aufbau/schematischer_aufbau_versorgung.dxf
5V
12V
Arduino Mega
Relais Modul 1
Relais Modul 2
Pumpe 1
Pumpe 2
Motor Fenster
Lüfter
Licht
Netzteil 12V/2,5A
Step-Down-Wandler 12V to 5V
Erdfeuchte 1
Erdfeuchte 2
Temperatur
LDR
REED-Kontakt
2
~230V
Display
