robotron10/project_x/(list of files, cad)

Other CAD files:
librecad/luefter/befestigung_luefter.dxf
