robotron10/project_x/doxygen/latex/make__string_8cpp__incl.pdf

/home/zero/abschlussprojekt /make_string.cpp

Arduino.h make_string.h
