robotron10/project_x/doxygen/latex/make__string_8cpp.tex

\hypertarget{make__string_8cpp}{}\section{/home/zero/abschlussprojekt/make\+\_\+string.cpp-\/\+Dateireferenz}
\label{make__string_8cpp}\index{/home/zero/abschlussprojekt/make\+\_\+string.\+cpp@{/home/zero/abschlussprojekt/make\+\_\+string.\+cpp}}
{\ttfamily \#include $<$Arduino.\+h$>$}\newline
{\ttfamily \#include \char`\"{}make\+\_\+string.\+h\char`\"{}}\newline
Include-\/\+Abhängigkeitsdiagramm für make\+\_\+string.\+cpp\+:
\nopagebreak
\begin{figure}[H]
\begin{center}
\leavevmode
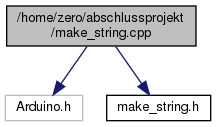
[picture p41: doxygen/html/make__string_8cpp__incl.png]

\end{center}
\end{figure}
\subsection*{Funktionen}
\begin{DoxyCompactItemize}
\item 
String \hyperlink{make__string_8cpp_a19ab0f1c20c9a665b3a65c5422e817a9}{make\+\_\+string} (String s)
\end{DoxyCompactItemize}

\subsection{Dokumentation der Funktionen}
\mbox{\Hypertarget{make__string_8cpp_a19ab0f1c20c9a665b3a65c5422e817a9}\label{make__string_8cpp_a19ab0f1c20c9a665b3a65c5422e817a9}} 
\index{make\+\_\+string.\+cpp@{make\+\_\+string.\+cpp}!make\+\_\+string@{make\+\_\+string}}
\index{make\+\_\+string@{make\+\_\+string}!make\+\_\+string.\+cpp@{make\+\_\+string.\+cpp}}
\subsubsection{\texorpdfstring{make\+\_\+string()}{make\_string()}}
{\footnotesize\ttfamily String make\+\_\+string (\begin{DoxyParamCaption}\item[{String}]{s }\end{DoxyParamCaption})}

Definiert in Zeile 5 der Datei make\+\_\+string.\+cpp.
