robotron10/project_x/doxygen/latex/make__string_8h.tex

\hypertarget{make__string_8h}{}\section{/home/zero/abschlussprojekt/make\+\_\+string.h-\/\+Dateireferenz}
\label{make__string_8h}\index{/home/zero/abschlussprojekt/make\+\_\+string.\+h@{/home/zero/abschlussprojekt/make\+\_\+string.\+h}}
Dieser Graph zeigt, welche Datei direkt oder indirekt diese Datei enthält\+:
\nopagebreak
\begin{figure}[H]
\begin{center}
\leavevmode
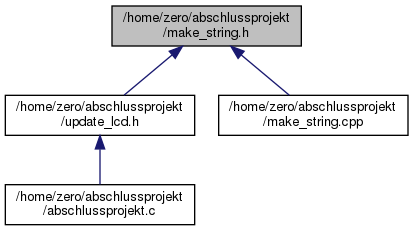
[picture p42: doxygen/html/make__string_8h__dep__incl.png]

\end{center}
\end{figure}
\subsection*{Funktionen}
\begin{DoxyCompactItemize}
\item 
String \hyperlink{make__string_8h_a19ab0f1c20c9a665b3a65c5422e817a9}{make\+\_\+string} (String s)
\end{DoxyCompactItemize}

\subsection{Dokumentation der Funktionen}
\mbox{\Hypertarget{make__string_8h_a19ab0f1c20c9a665b3a65c5422e817a9}\label{make__string_8h_a19ab0f1c20c9a665b3a65c5422e817a9}} 
\index{make\+\_\+string.\+h@{make\+\_\+string.\+h}!make\+\_\+string@{make\+\_\+string}}
\index{make\+\_\+string@{make\+\_\+string}!make\+\_\+string.\+h@{make\+\_\+string.\+h}}
\subsubsection{\texorpdfstring{make\+\_\+string()}{make\_string()}}
{\footnotesize\ttfamily String make\+\_\+string (\begin{DoxyParamCaption}\item[{String}]{s }\end{DoxyParamCaption})}

Definiert in Zeile 5 der Datei make\+\_\+string.\+cpp.
