robotron10/project_x/doxygen/latex/make__string_8h__dep__incl.pdf

/home/zero/abschlussprojekt /make_string.h

/home/zero/abschlussprojekt /update_lcd.h

/home/zero/abschlussprojekt /make_string.cpp

/home/zero/abschlussprojekt /abschlussprojekt.c
