robotron10/project_x/qelectrotech/verdrahtung/schematische_beschaltung.pdf

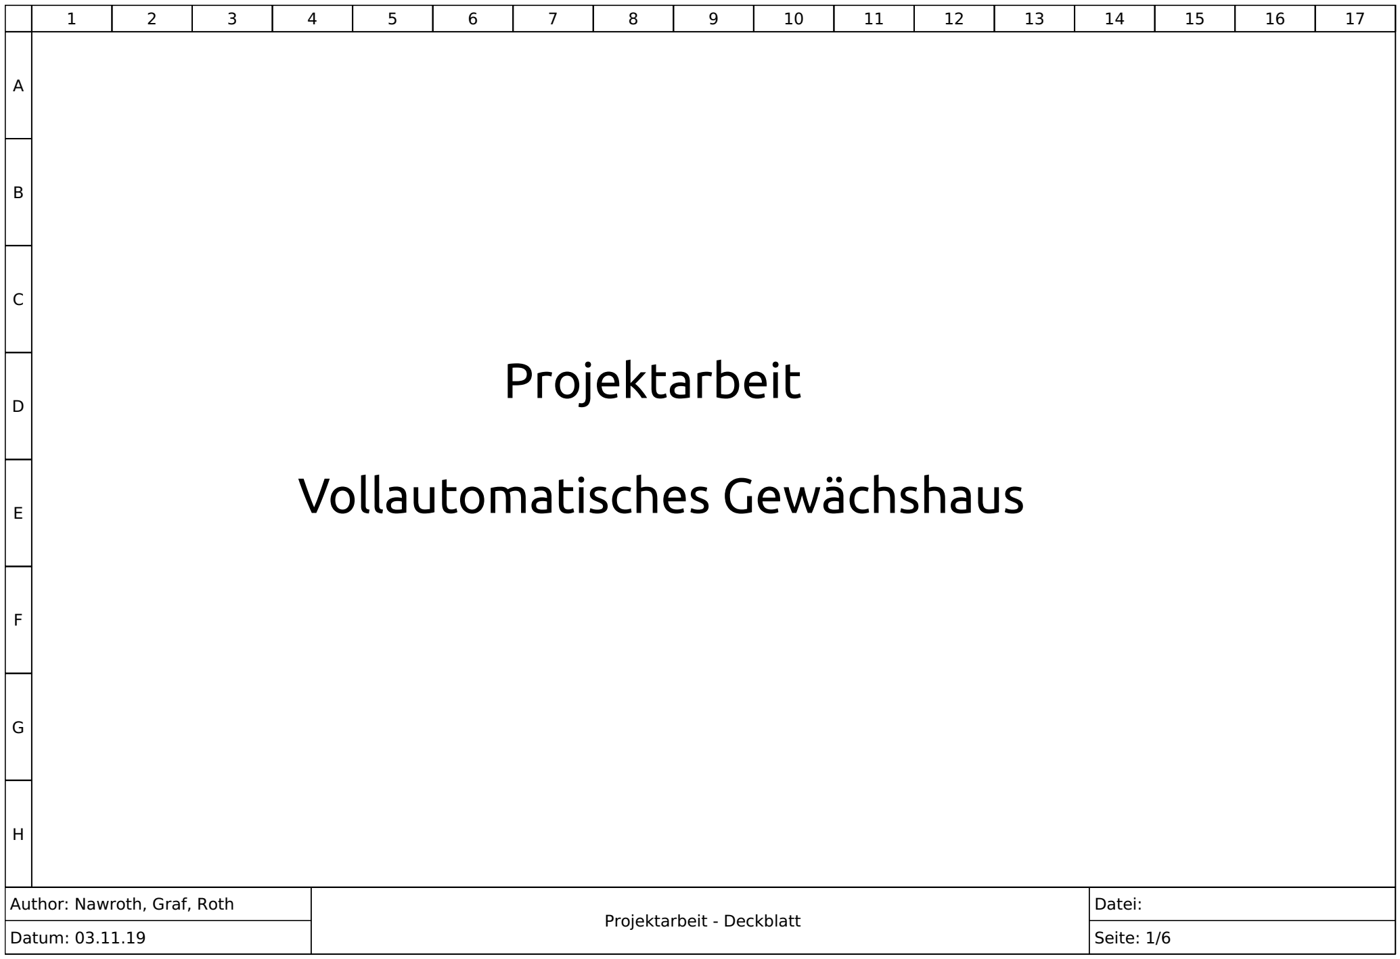
[picture p43: figure]
Author: Nawroth, Graf, Roth; Projektarbeit - Deckblatt; Datei:; Datum: 03.11.19; Seite: 1/6; Projektarbeit; Vollautomatisches Gewächshaus
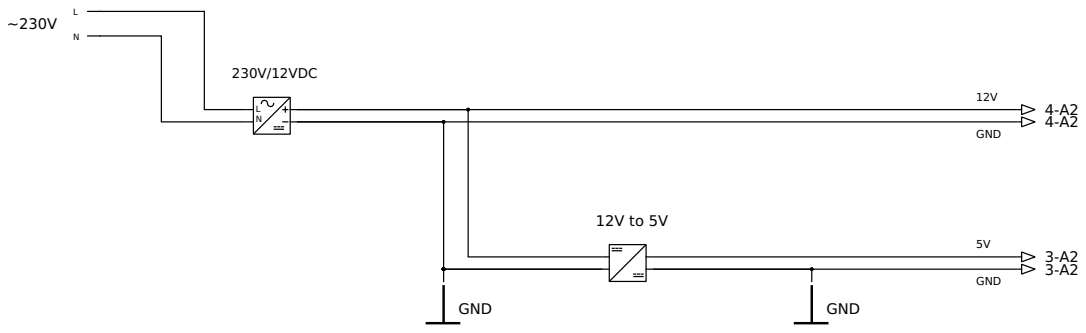
[picture p44: page 2]
Projektarbeit - Netzbeschaltung; Datei:; GND; 230V/12VDC

Author: Nawroth, Graf, Roth

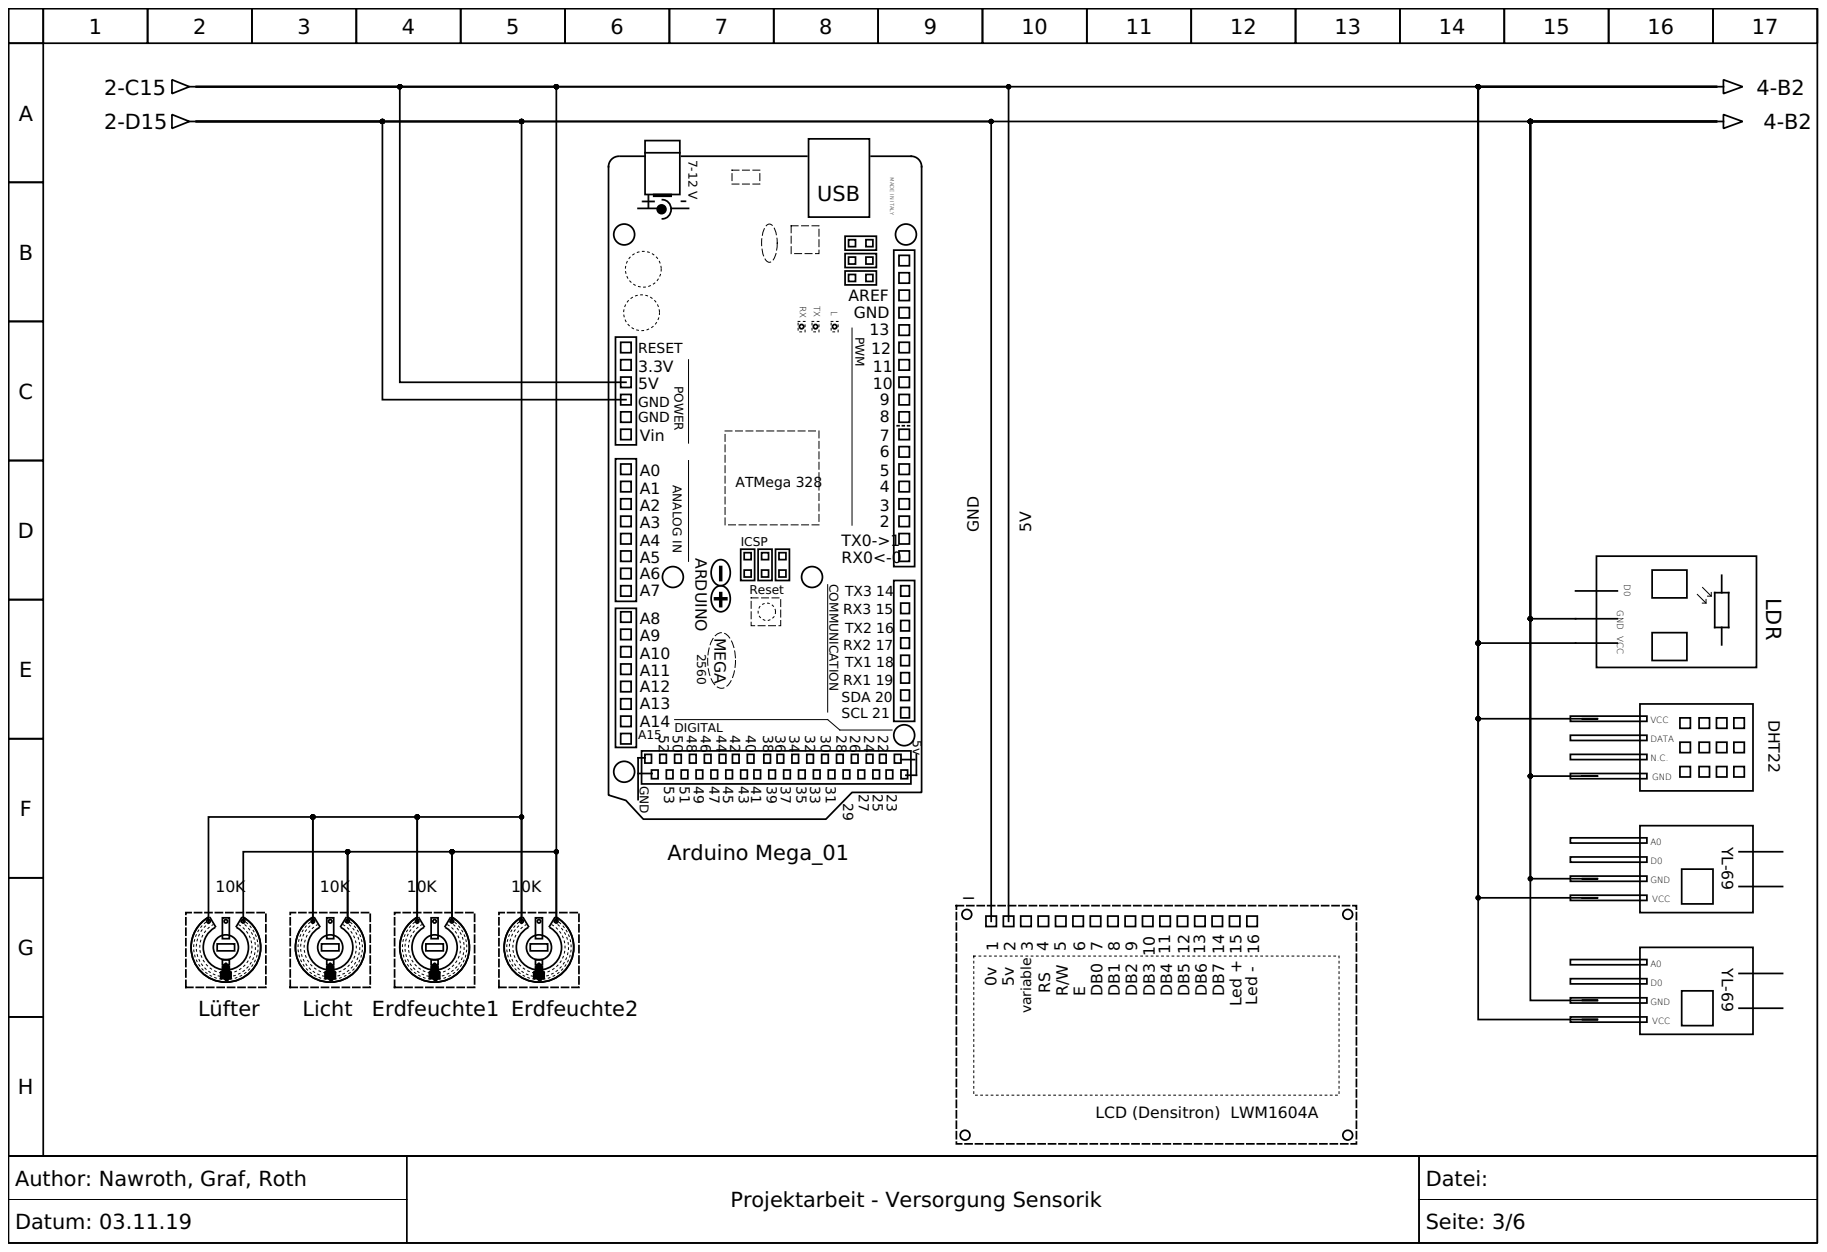
[picture p45: page 3]
Datei:; GND; Lüfter; Licht; Erdfeuchte1; Erdfeuchte2; Led -; Led +; variable; LCD (Densitron) LWM1604A; DATA; VCC; DHT22; SDA 20 SCL 21; ICSP; MEG; DIGITAL; COMMUNICATION; GND Vin; RESET; AREF GND; ARDUINO; Reset; ATMega 328; Arduino Mega_01; VCC GND

MADE IN ITALY
USB

ANALOG IN POWER

Author: Nawroth, Graf, Roth

Projektarbeit - Versorgung Sensorik

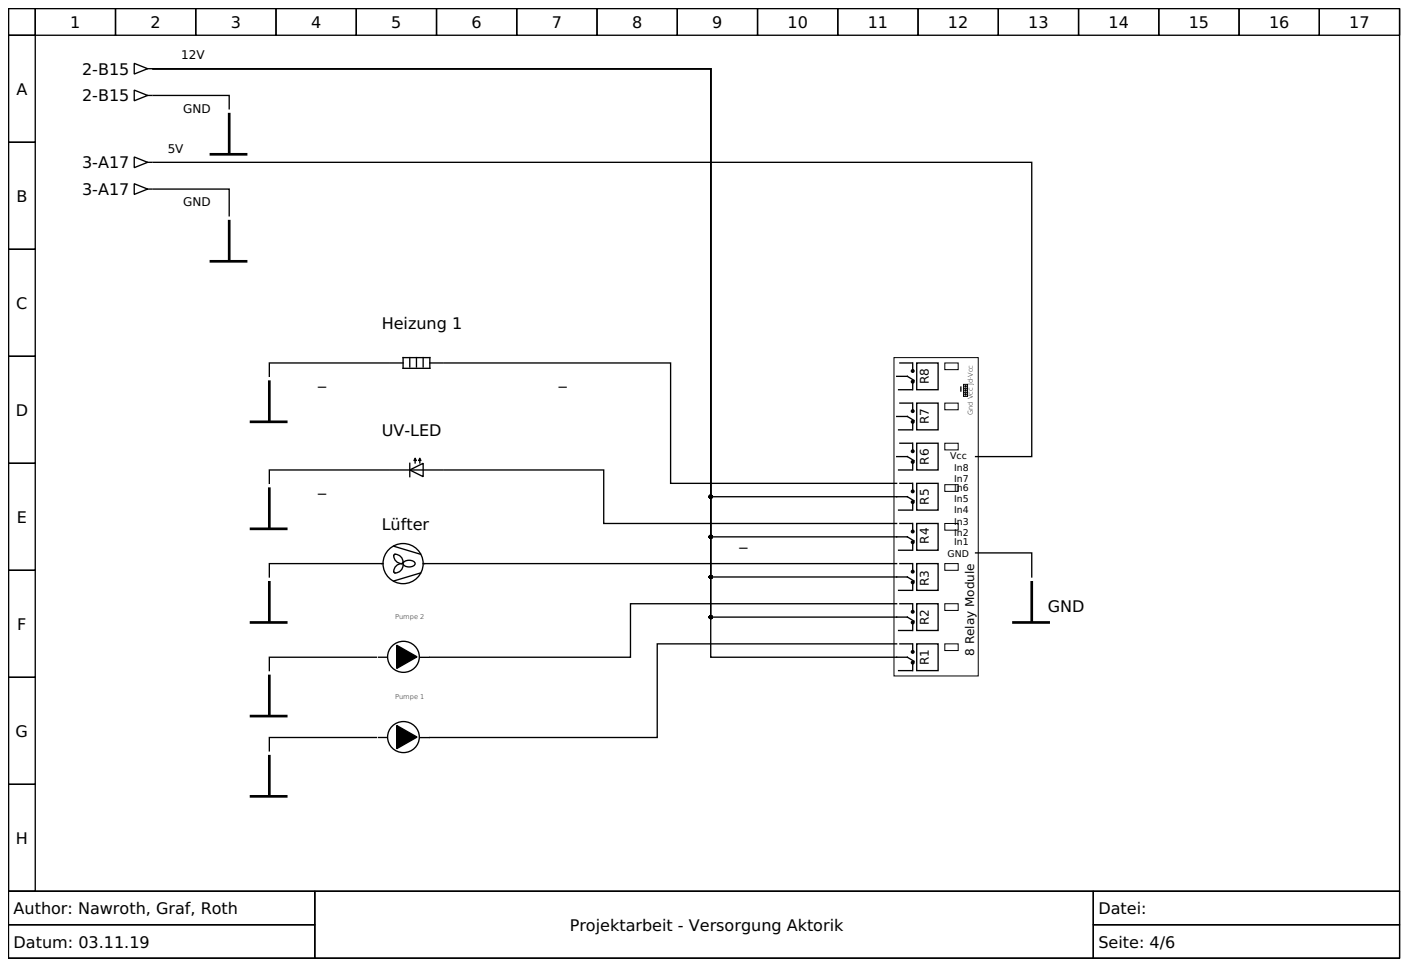
[picture p46: page 4]

Gnd Vcc Jd-Vcc

Author: Nawroth, Graf, Roth

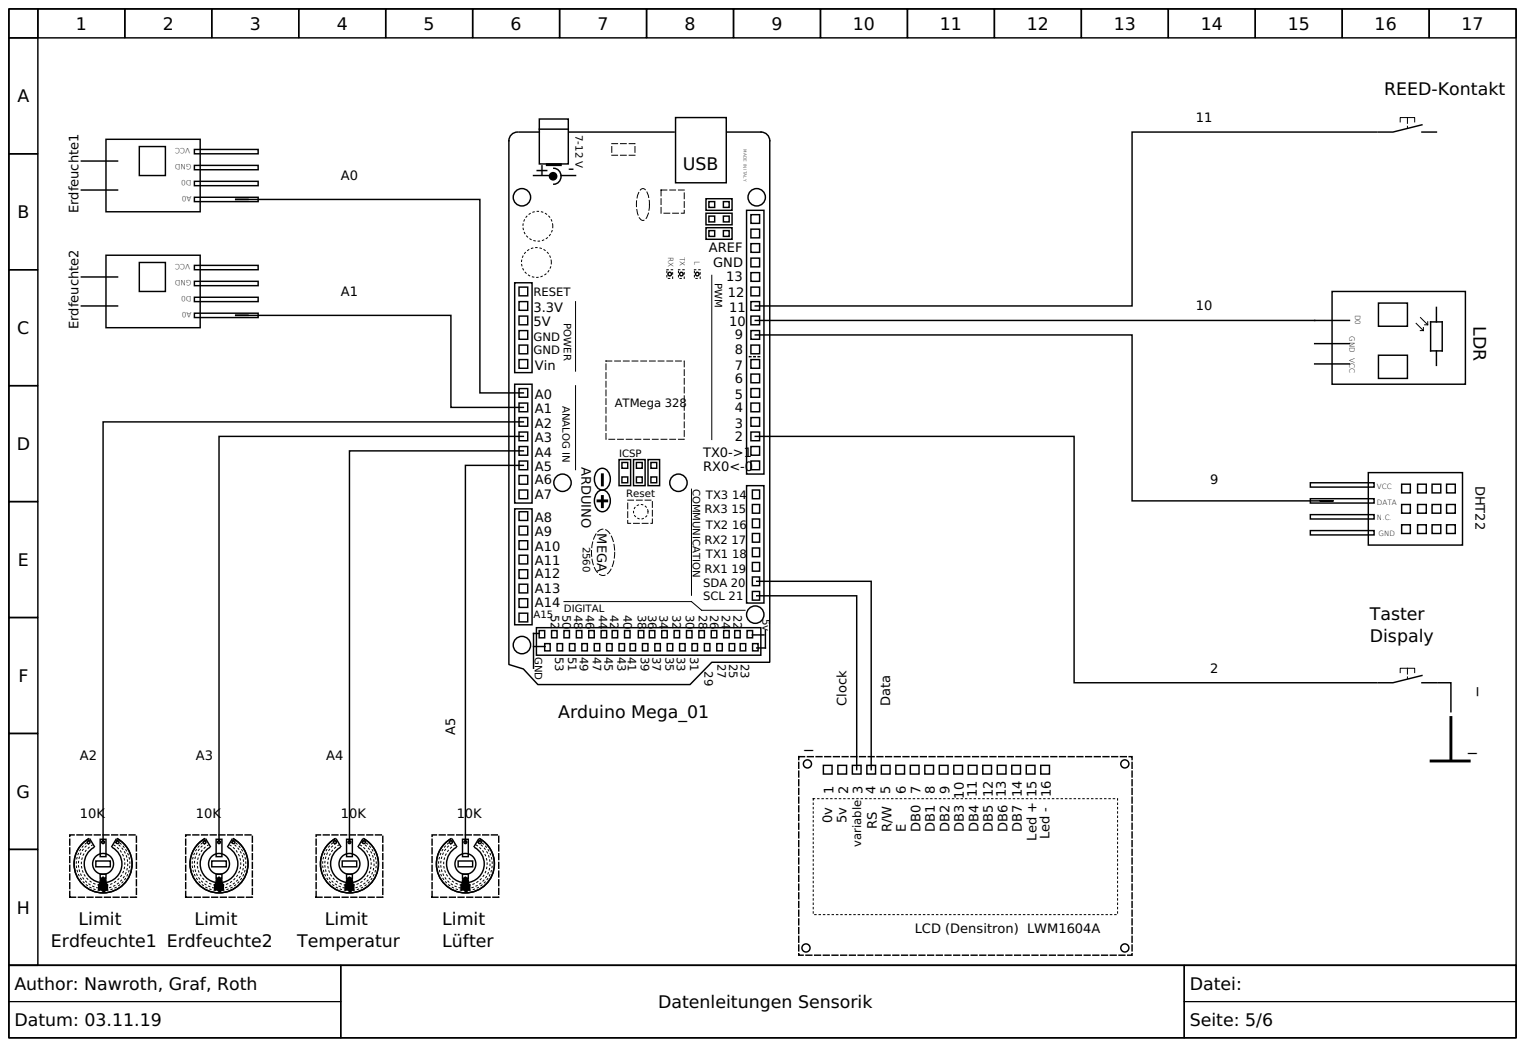
[picture p47: page 5]
Datenleitungen Sensorik; Datei:; Clock; Data; Taster Dispaly; REED-Kontakt; VCC GND; SDA 20 SCL 21; ICSP; MEG; DIGITAL; COMMUNICATION; GND; GND Vin; RESET; AREF GND; ARDUINO; Reset; ATMega 328; Arduino Mega_01; Erdfeuchte2; Erdfeuchte1; DATA; VCC; DHT22; Led -; Led +; variable; LCD (Densitron) LWM1604A; Limit Erdfeuchte2; Limit Erdfeuchte1; Limit Temperatur; Limit Lüfter

MADE IN ITALY
USB

ANALOG IN POWER

Author: Nawroth, Graf, Roth

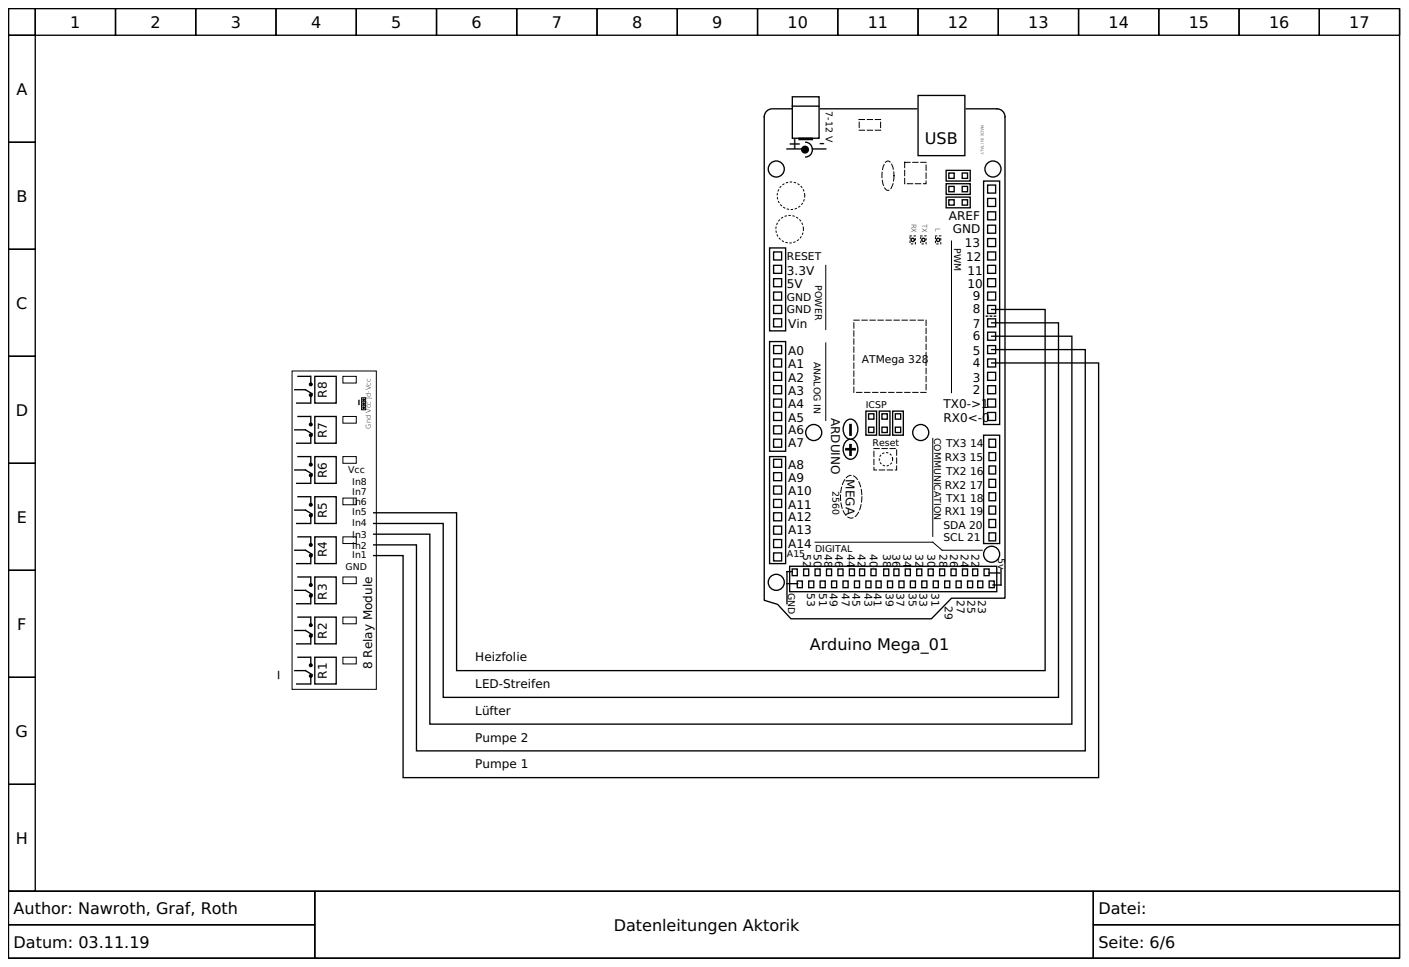
[picture p48: page 6]
ABCDEFGHAu; nleit; rik; ei: Datum: 03.11.19; Seite: 6; eiz; olie; eif; 8 Relay Module; 31 ICSP; MEGA; DIGIT; COMMUNICATION; D Vin; ANALOG IN POWER; ARDUINO; GND; uin

MADE IN ITALY

Gnd Vcc Jd-Vcc
