robotron10/project_x/kicad/Steuerung/Steuerung.pdf

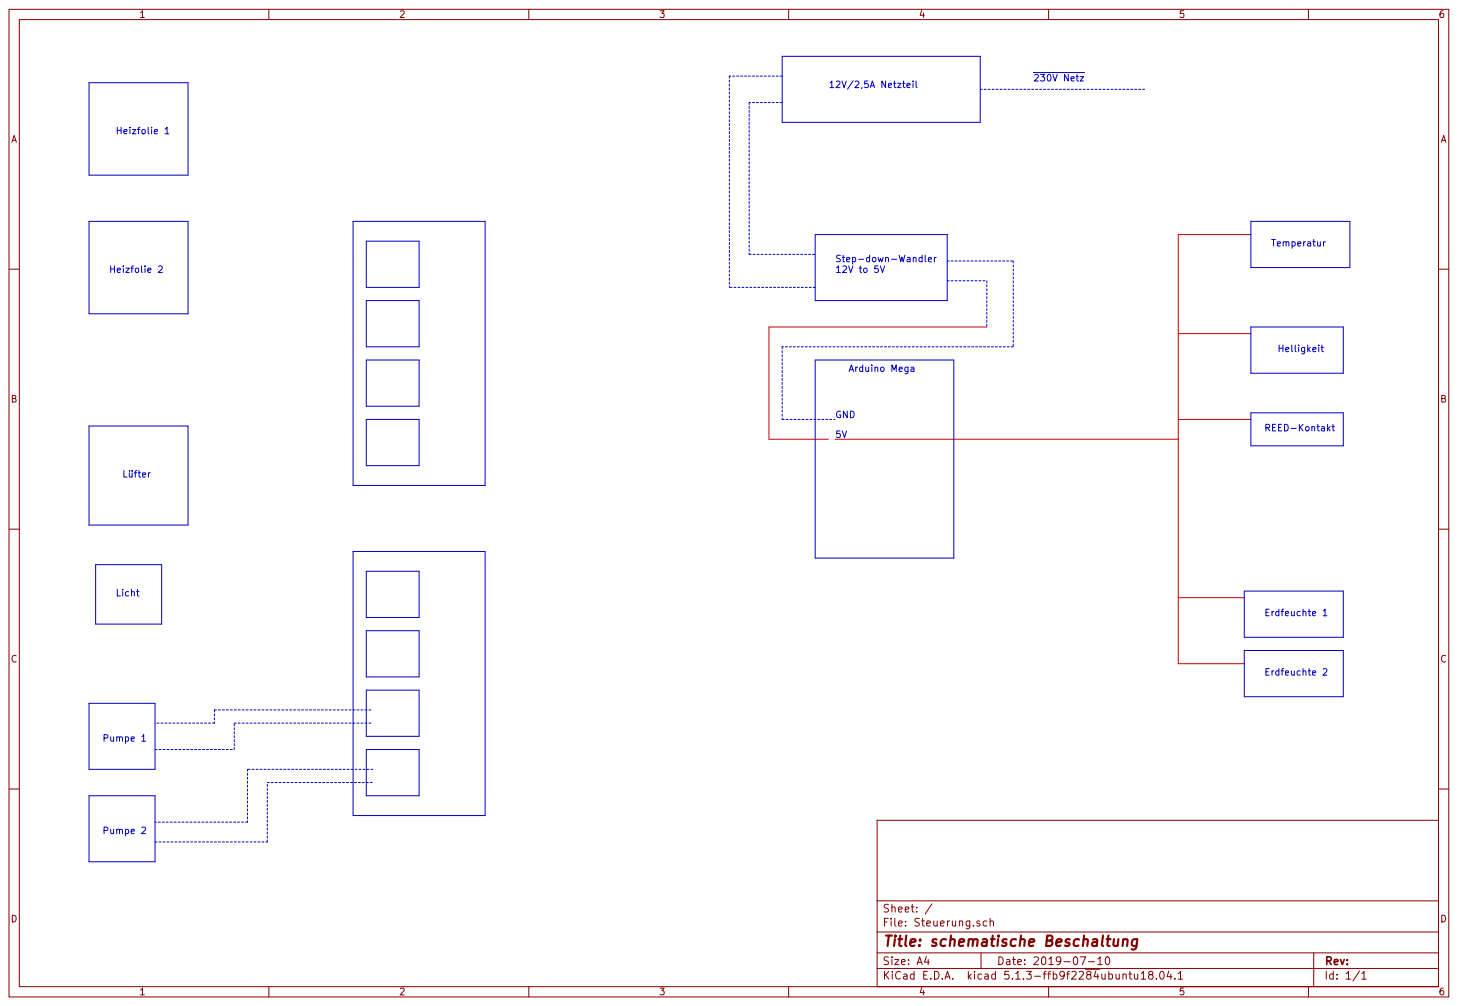
[picture p49: page 1]

230V Netz Step-down-Wandler 12V to 5V

File: Steuerung.sch Sheet: /
Id: 1/1 Title: schematische Beschaltung
