robotron10/project_x/doxygen/doxygen_prog_uebersicht.pdf

## abschlussprojekt.c-Dateireferenz

#include "makros.h"

#include "tuer_zu.h"

#include "pumpe_1.h"

#include "pumpe_2.h"

#include "update_limits.h"

#include "update_lcd.h"

#include "update_messwerte.h"

Include-Abhängigkeitsdiagramm für abschlussprojekt.c:

gehe zum Quellcode dieser Datei

## Funktionen

void | setup ()
void | loop ()

## Variablen

unsigned long | t0_temperaturmessung
unsigned long | dt_temperaturmessung_ms = 2000
unsigned long | t0_display
unsigned long | dt_display_ms = 2000
unsigned long | t0_erdfeuchtemessung
unsigned long | dt_erdfeuchtemessung_ms = 5000
unsigned long | t0_heizung
unsigned long | dt_heizung_ms = 5000
unsigned long | t0_luefter
unsigned long | dt_luefter_ms = 5000
unsigned long | t0_helligkeit
unsigned long | dt_helligkeit_ms = 5000
int | hum_erde_1_adc
int | hum_erde_2_adc
int | hum_luft
int | temp_luft_C
int | limit_feuchte_1_adc
Abschlussprojekt vollautomatisches Gewächshau... | file:///home/zero/project_x/doxygen/html/abschl...
1 von 6 | 08.11.19, 11:09

## Dokumentation der Funktionen

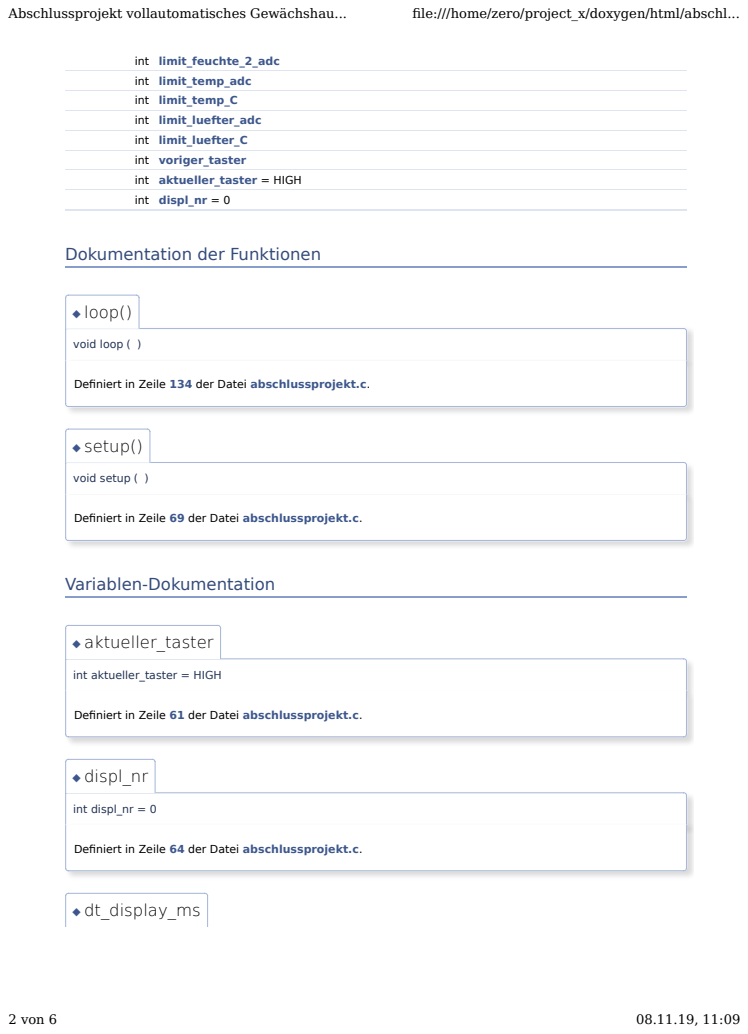
[picture p50: page 2]
◆ loop(); ◆ setup(); ◆ aktueller_taster; ◆ displ_nr; ◆ dt_display_ms; void loop (; void setup (; Variablen-Dokumentation; int aktueller_taster = HIGH; int displ_nr = 0

int | limit_feuchte_2_adc
int | limit_temp_adc
int | limit_temp_C
int | limit_luefter_adc
int | limit_luefter_C
int | voriger_taster
int | aktueller_taster = HIGH
int | displ_nr = 0

Definiert in Zeile 134 der Datei abschlussprojekt.c.

Definiert in Zeile 69 der Datei abschlussprojekt.c.

Definiert in Zeile 61 der Datei abschlussprojekt.c.

Definiert in Zeile 64 der Datei abschlussprojekt.c.

## ◆ dt_erdfeuchtemessung_ms

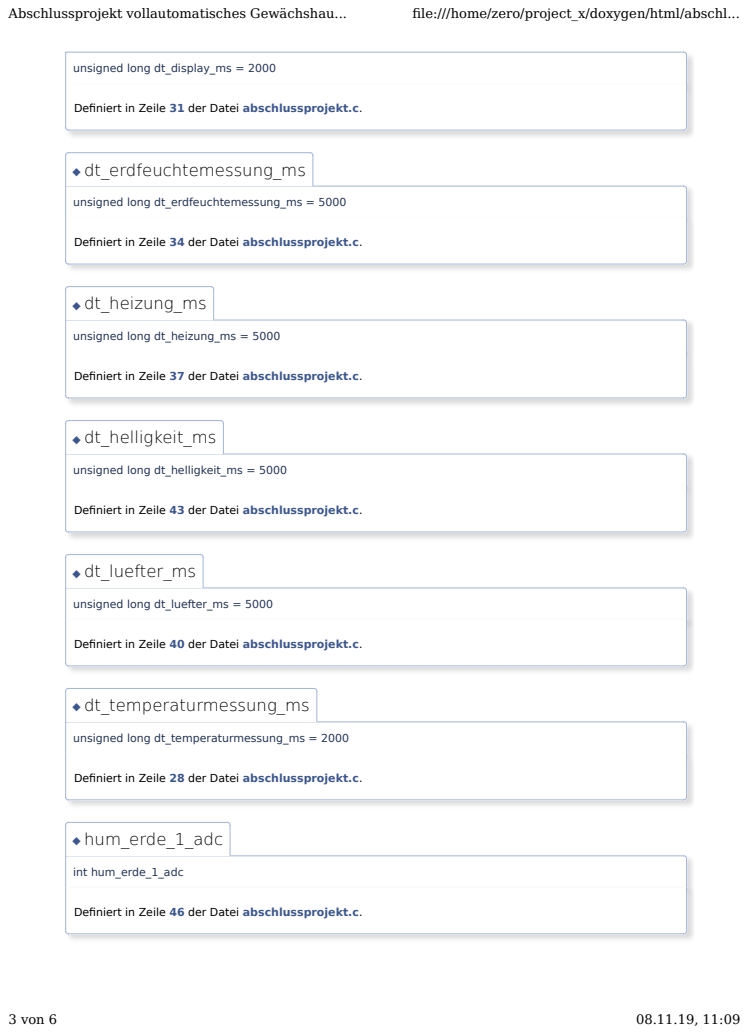
[picture p51: page 3]
◆ dt_heizung_ms; ◆ dt_helligkeit_ms; ◆ dt_luefter_ms; ◆ dt_temperaturmessung_ms; ◆ hum_erde_1_adc; unsigned long dt_display_ms = 2000; unsigned long dt_erdfeuchtemessung_ms = 5000; unsigned long dt_heizung_ms = 5000; unsigned long dt_helligkeit_ms = 5000; unsigned long dt_luefter_ms = 5000; unsigned long dt_temperaturmessung_ms = 2000; int hum_erde_1_adc

Definiert in Zeile 31 der Datei abschlussprojekt.c.

Definiert in Zeile 34 der Datei abschlussprojekt.c.

Definiert in Zeile 37 der Datei abschlussprojekt.c.

Definiert in Zeile 43 der Datei abschlussprojekt.c.

Definiert in Zeile 40 der Datei abschlussprojekt.c.

Definiert in Zeile 28 der Datei abschlussprojekt.c.

Definiert in Zeile 46 der Datei abschlussprojekt.c.

## ◆ hum_erde_2_adc

## ◆ hum_luft

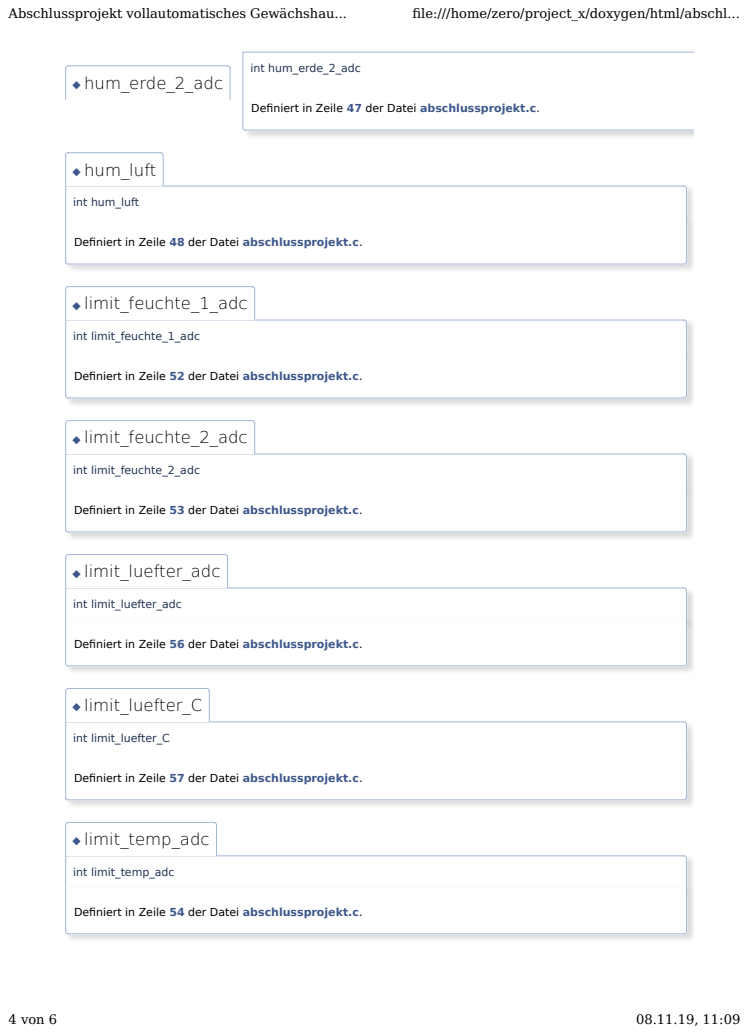
[picture p52: page 4]
◆ limit_feuchte_1_adc; ◆ limit_feuchte_2_adc; ◆ limit_luefter_adc; ◆ limit_luefter_C; ◆ limit_temp_adc; int hum_erde_2_adc; int hum_luft; int limit_feuchte_1_adc; int limit_feuchte_2_adc; int limit_luefter_adc; int limit_luefter_C; int limit_temp_adc

Definiert in Zeile 47 der Datei abschlussprojekt.c.

Definiert in Zeile 48 der Datei abschlussprojekt.c.

Definiert in Zeile 52 der Datei abschlussprojekt.c.

Definiert in Zeile 53 der Datei abschlussprojekt.c.

Definiert in Zeile 56 der Datei abschlussprojekt.c.

Definiert in Zeile 57 der Datei abschlussprojekt.c.

Definiert in Zeile 54 der Datei abschlussprojekt.c.

## ◆ limit_temp_C

## ◆ t0_display

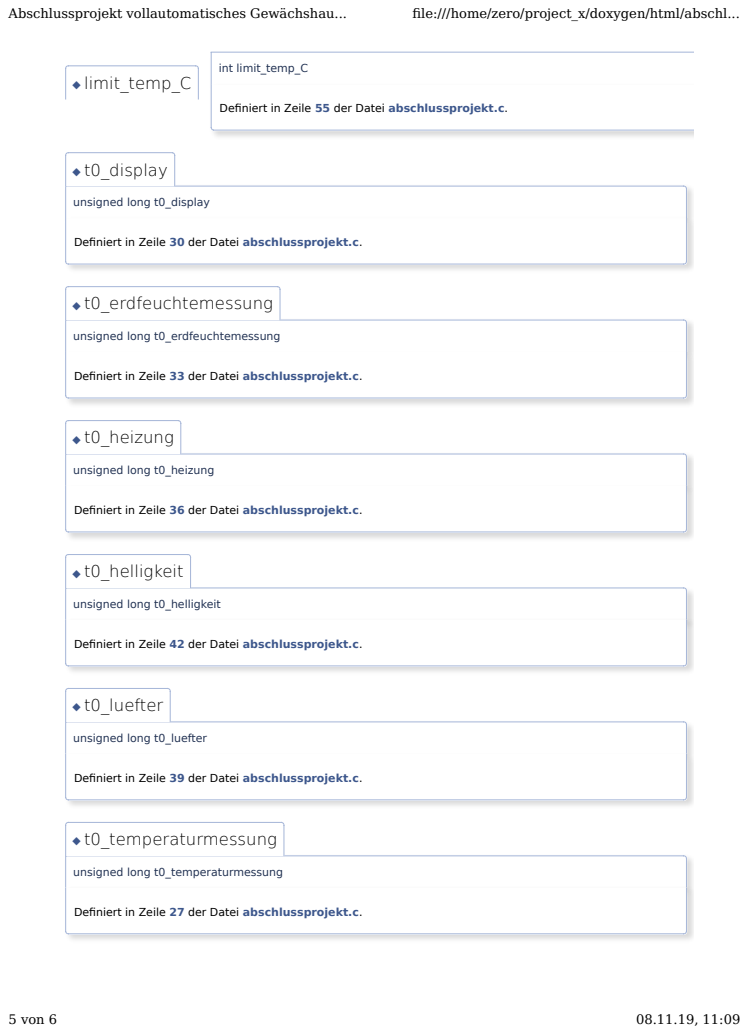
[picture p53: page 5]
◆ t0_erdfeuchtemessung; ◆ t0_heizung; ◆ t0_helligkeit; ◆ t0_luefter; ◆ t0_temperaturmessung; int limit_temp_C; unsigned long t0_display; unsigned long t0_erdfeuchtemessung; unsigned long t0_heizung; unsigned long t0_helligkeit; unsigned long t0_luefter; unsigned long t0_temperaturmessung

Definiert in Zeile 55 der Datei abschlussprojekt.c.

Definiert in Zeile 30 der Datei abschlussprojekt.c.

Definiert in Zeile 33 der Datei abschlussprojekt.c.

Definiert in Zeile 36 der Datei abschlussprojekt.c.

Definiert in Zeile 42 der Datei abschlussprojekt.c.

Definiert in Zeile 39 der Datei abschlussprojekt.c.

Definiert in Zeile 27 der Datei abschlussprojekt.c.

## ◆ temp_luft_C

## ◆ voriger_taster

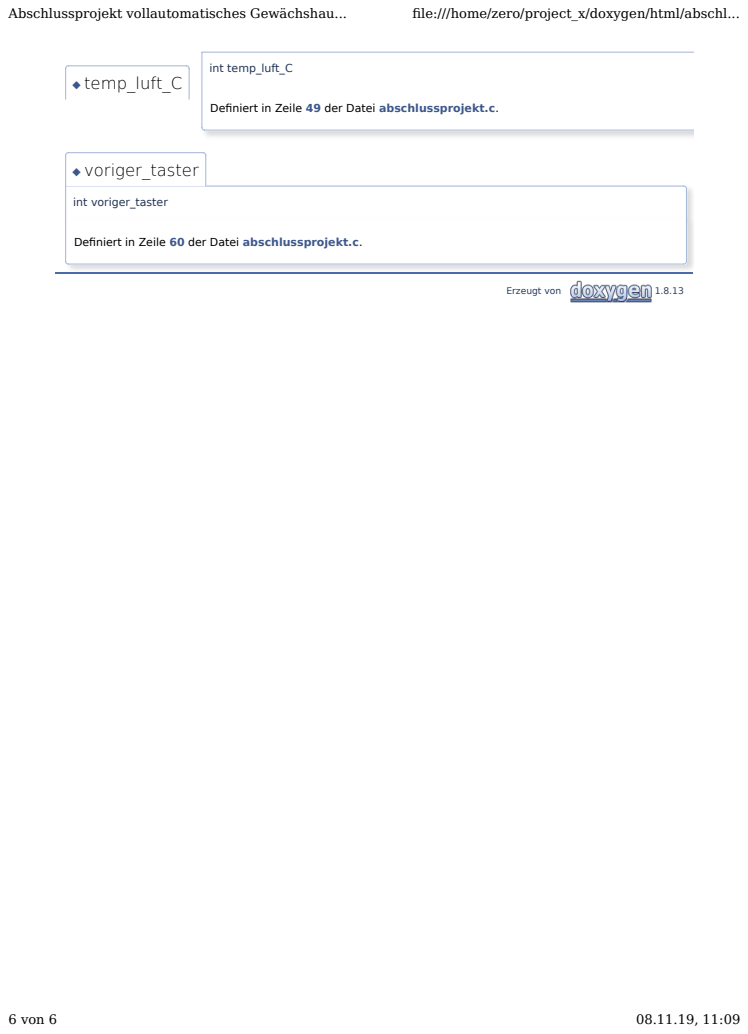
[picture p54: page 6]
int temp_luft_C; int voriger_taster; Erzeugt von

Definiert in Zeile 49 der Datei abschlussprojekt.c.

Definiert in Zeile 60 der Datei abschlussprojekt.c.
