robotron10/project_x/kicad/dsub_1/dsub_1.pdf

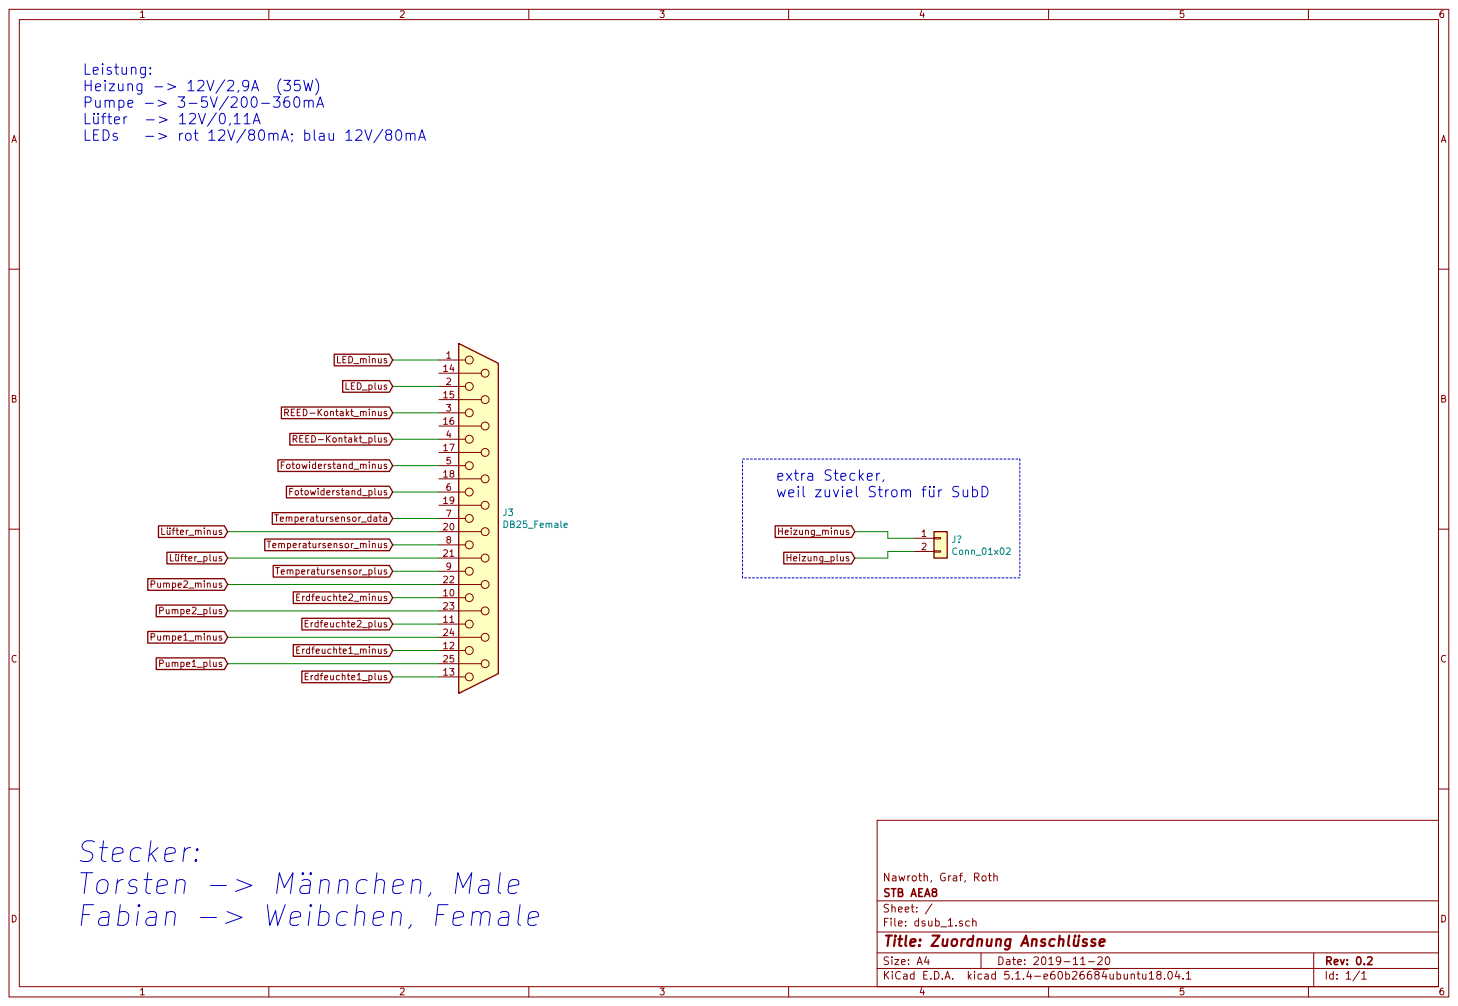
[picture p55: page 1]

extra Stecker,
weil zuviel Strom für SubD

File: dsub_1.sch Sheet: / STB AEA8 Nawroth, Graf, Roth

Id: 1/1 Title: Zuordnung Anschlüsse
