robotron10/project_x/kicad/Drossel_Pumpe/Drossel_Pumpe.pdf

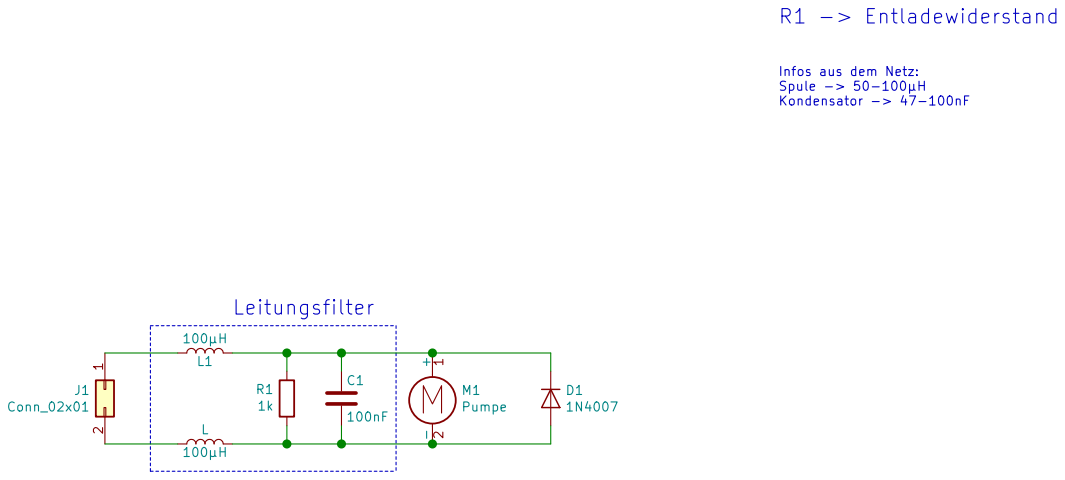
[picture p56: page 1]

Infos aus dem Netz: Spule -> 50-100µH

File: Drossel_Pumpe.sch Sheet: / STB AEA8 Nawroth, Graf, Roth

Id: 1/1 Title: Leitungsfilter für die Wasserpumpe
