robotron10/project_x/librecad/luefter/befestigung_luefter.pdf

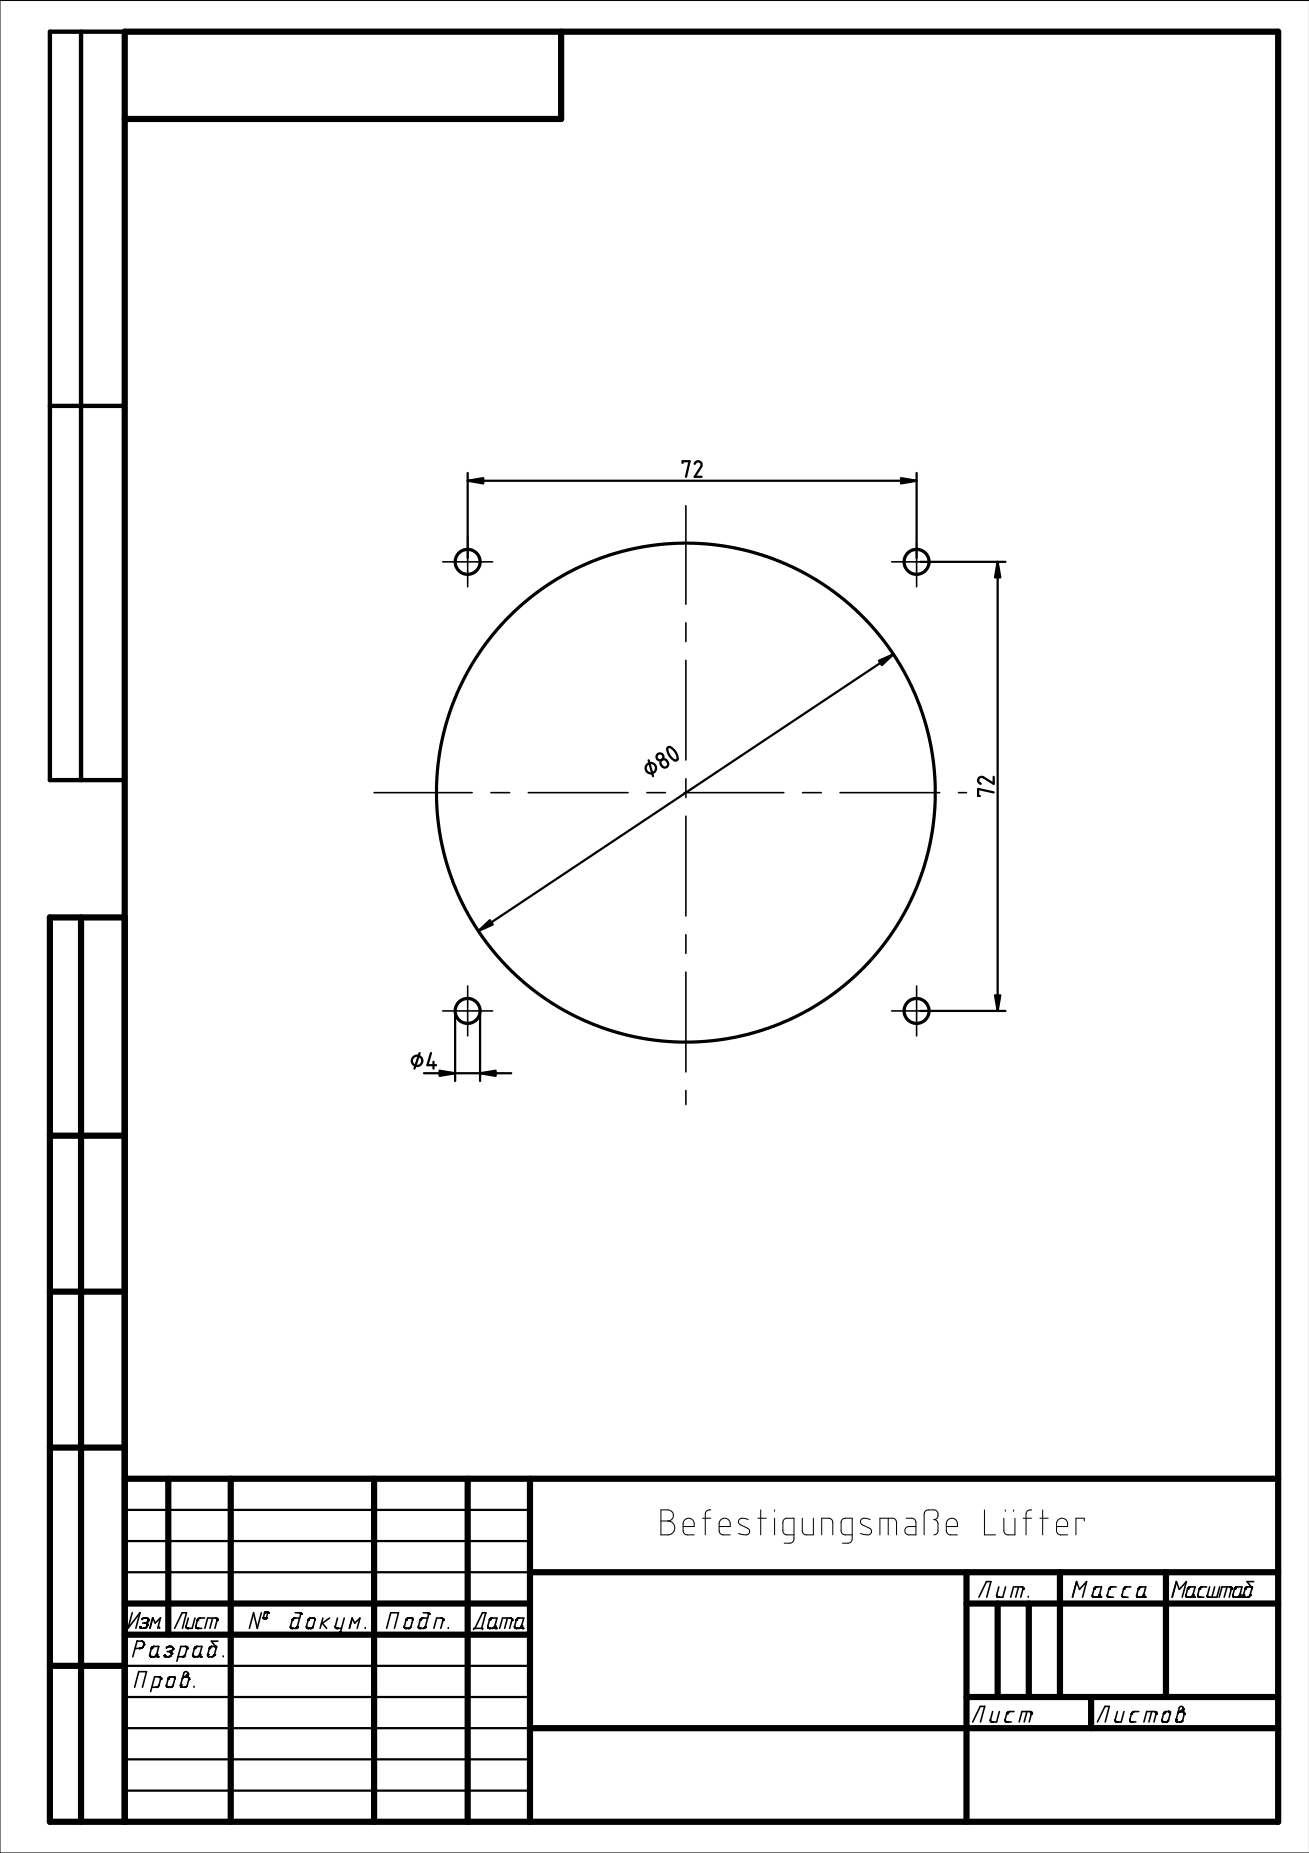
[picture p57: page 1]
