robotron10/project_x/abschlussprojekt/make_string.cpp

#include <Arduino.h>
#include "make_string.h"


String make_string( String s ) {                                                                //  erstelle String
  while ( s.length() < 20 ) {                                                                   //  wenn String-Länge kleiner als 20
    s = s + " ";                                                                                //  füge ein Leerzeichen ein
  }
  return s;                                                                                     //  Wert s zurückgeben
}
