robotron10/project_x/abschlussprojekt/make_string.h

/////////////////////////////////////////////////////
// diese Funtion wird in "update_lcd.h" benötigt  ///
/////////////////////////////////////////////////////

// Prototyp
String make_string( String s ) ;
