robotron10/project_x/(commit log)

2019-06-06 neue Datei: 2019_Abschlussprojekt_Zuordnugstabelle.ods geändert: Variablennamen geändert, Erdfeuchtesensor mit Relais verknüpft, LCD-Ausgabe verbessert
    [2019_Abschlussprojekt_Zuordnugstabelle.ods]
2019-06-11 geändert: Übergangsautomat für Erdfeuchtemessung, Relais Heizung, Umdrehung der Relaislogik
2019-06-26 geändert: Helligkeitssensor ohne Test, neue LIB für LCD_I2C, Lüfter, Motor_Fenster, erste Idee REDD-Kontakt
2019-06-26 geändert: Einlesen des Potis und in Vareable schreiben
2019-07-04 geändert: lokale Variablen, ADC + LCD getrennt, Code auslagern, Reed-Kontakt neue Datei: abschlussprojekt/update_limits.h
2019-07-10 neue Datei: datasheets/4KanalRelaisModul.df neue Datei: datasheets/Allgemeine_Daten.txt neue Datei: datasheets/Atmel-2549-8-bit-AVR-Microcontroller.pdf neue Datei: datasheets/DHT22.pdf neue Datei: da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
    [Drossel_Pumpe-2019-07-10-12-13-16.sch, Drossel_Pumpe.kicad_pcb, Drossel_Pumpe.sch, Steuerung.kicad_pcb, Steuerung.sch]
2019-07-28 neue Datei: datasheets/Servomotor_DS3218.pdf
2019-08-07 geändert: kicad/Steuerung/Steuerung/Steuerung-cache.lib geändert: kicad/Steuerung/Steuerung/Steuerung.bak geändert: kicad/Steuerung/Steuerung/Steuerung.pdf geändert: kicad/Steuerung/Steuerung/Steueru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
    [Steuerung.sch, schematischer_aufbau_versorgung.dxf]
2019-08-09 neue Datei: Stueckliste.ods neue Datei: datasheets/DC-DC_converter.jpg neue Datei: datasheets/arduino-mega-pinout-diagram.png neue Datei: librecad/befestigung_luefter.dxf~ neue Datei: librecad/luefte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
    [Stueckliste.ods, befestigung_luefter.dxf]
2019-08-16 geändert: abschlussprojekt/abschlussprojekt.ino -> Code neu kommentiert umbenannt: kicad/Steuerung/Steuerung/Steuerung-cache.lib -> kicad/Steuerung/Steuerung-cache.lib umbenannt: kicad/Steuerung/Steu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
    [Steuerung.kicad_pcb, Steuerung.sch, dsub_1.kicad_pcb, dsub_1.sch]
2019-09-09 umbenannt: 2019_Abschlussprojekt_Zuordnugstabelle.ods -> Doku/2019_Abschlussprojekt_Zuordnugstabelle.ods neue Datei: Doku/Anmerungen_fuer_Doku.odt umbenannt: Stueckliste.ods -> Doku/Stueckliste.ods g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
    [2019_Abschlussprojekt_Zuordnugstabelle.ods, Drossel_Pumpe.sch, Stueckliste.ods]
2019-09-12 geändert: Doku/Anmerungen_fuer_Doku.odt geändert: Doku/Tagebuch_Ziele.odt geändert: abschlussprojekt/abschlussprojekt.ino -> Helligkeitssensor + LEDs implementiert geändert: kicad/dsub_1/dsub_1.bak g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
    [dsub_1.sch]
2019-09-14 geändert: abschlussprojekt/abschlussprojekt.ino -> Heizung, geändert: kicad/Drossel_Pumpe/Drossel_Pumpe-cache.lib geändert: kicad/Drossel_Pumpe/Drossel_Pumpe.bak geändert: kicad/Drossel_Pumpe/Drossel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
    [Drossel_Pumpe.sch]
2019-09-15 geändert: abschlussprojekt/abschlussprojekt.ino gelöscht: abschlussprojekt/update_limits.h neue Datei: abschlussprojekt/update_messwerte.c neue Datei: abschlussprojekt/update_messwerte.h geändert: ki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
    [dsub_1.sch]
2019-09-16 neue Datei: Doku/Deklaration_Definition.txt geändert: Doku/Tagebuch_Ziele.odt neue Datei: Doku/arduino_main.txt geändert: abschlussprojekt/abschlussprojekt.ino neue Datei: doxygen/Doxyfile neue Datei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
2019-09-26 geändert: Doku/Anmerungen_fuer_Doku.odt neue Datei: Doku/Anmerungen_fuer_Doku.pdf geändert: Doku/Tagebuch_Ziele.odt geändert: kicad/dsub_1/dsub_1.bak geändert: kicad/dsub_1/dsub_1.pdf geändert: kicad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
    [dsub_1.sch]
2019-09-27 geändert: Doku/Tagebuch_Ziele.odt neue Datei: Doku/Tagebuch_Ziele.pdf geändert: abschlussprojekt/abschlussprojekt.ino gelöscht: abschlussprojekt/update_messwerte.cpp gelöscht: abschlussprojekt/update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
    [dsub_1.sch]
2019-10-14 geändert: abschlussprojekt/abschlussprojekt.ino neue Datei: abschlussprojekt/make_string.h neue Datei: abschlussprojekt/makros.h neue Datei: abschlussprojekt/pumpe_1.h neue Datei: abschlussprojekt/pu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
2019-10-28 neue Datei: Doku/Aufbau_2.2.3_Arduino.odt geändert: Doku/Aufbau_2.3.odt geändert: kicad/Drossel_Pumpe/Drossel_Pumpe.pdf geändert: kicad/Drossel_Pumpe/Drossel_Pumpe.sch neue Datei: kicad/Drossel_Pumpe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
2019-11-04 geändert: abschlussprojekt/abschlussprojekt.ino geändert: kicad/Drossel_Pumpe/Drossel_Pumpe.pdf geändert: kicad/Drossel_Pumpe/Drossel_Pumpe.sch geändert: kicad/Drossel_Pumpe/Drossel_Pumpe.sch-bak geä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
    [Drossel_Pumpe.sch]
2019-11-04 neue Datei: "Doku/Dokumentation_Gew\303\244chshaus_fabi.odt" neue Datei: "Doku/Dokumentation_Gew\303\244chshaus_fabi.pdf" geändert: abschlussprojekt/abschlussprojekt.ino kopiert: abschlussprojekt/mak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
2019-11-20 geändert: kicad/dsub_1/dsub_1.pdf geändert: kicad/dsub_1/dsub_1.sch geändert: kicad/dsub_1/dsub_1.sch-bak
    [dsub_1.sch]
